Team-Sagittarius-ENTC/RGBsensor/poojitha/keyboard_second_solution/AKP-2.jpg

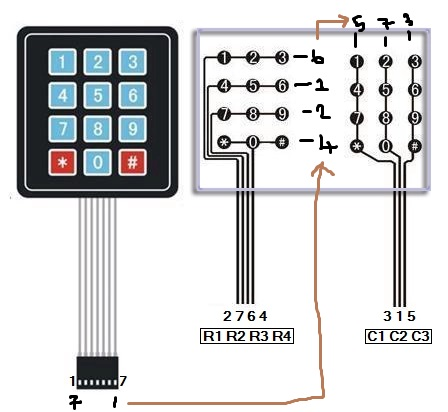
poojitha/keyboard_second_solution/AKP-2.jpg
