Team-Sagittarius-ENTC/RGBsensor/poojitha/keyboard_second_solution/AKP-2.webp

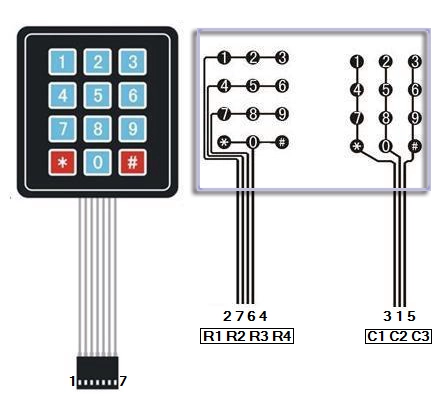
poojitha/keyboard_second_solution/AKP-2.webp
