Team-Sagittarius-ENTC/RGBsensor/Shared links.txt

Notion
------
https://www.notion.so/RGB-sensor-project-6d011d6d5c9f4d6bbc16852361c6ef57
