Team-Sagittarius-ENTC/RGBsensor/poojitha/Keypad and connections.pptx

## Keypad and connections

- To reduce the number of pins, we used resistor-based keypad(Now we use only one pin).
(idea : For pressing every key we get
different resultant resistor combination.)
- By practical, we obtain values for each key
pressed.

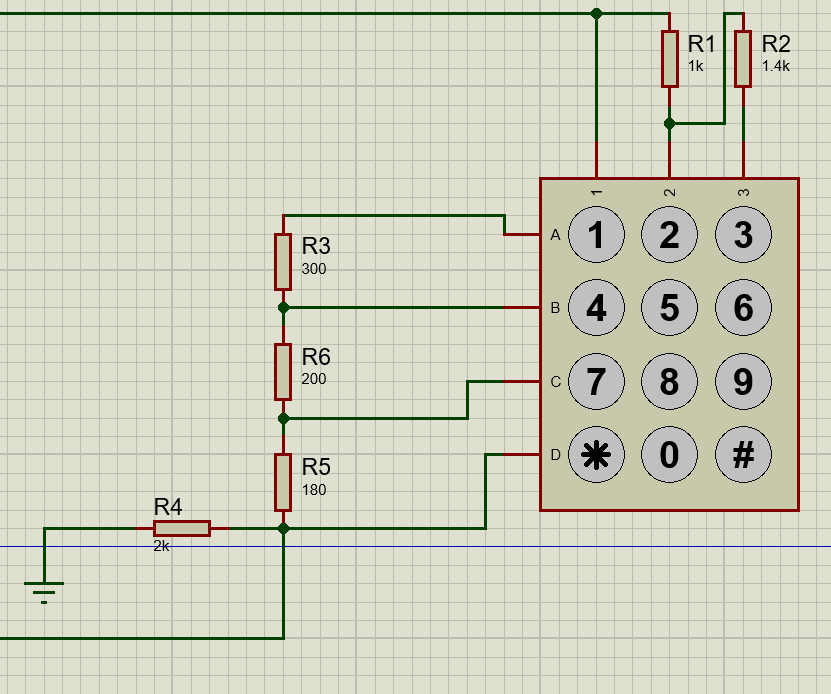
[picture p18: figure]

Get the analog read

## Keypad and connections

- Then we create Keypad library.

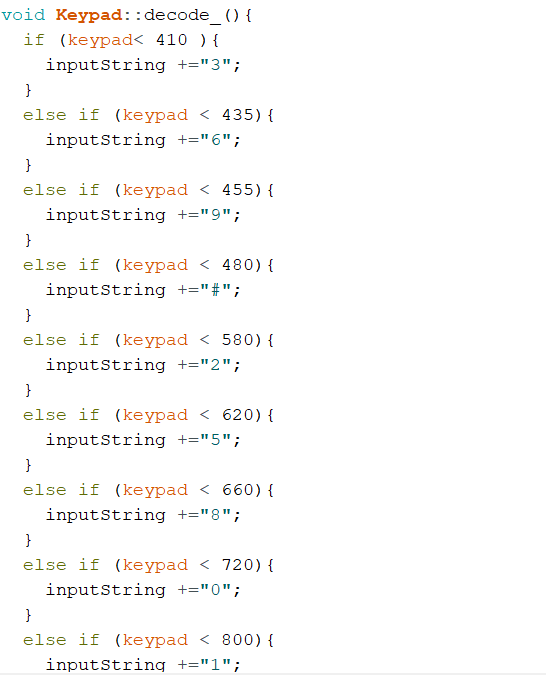
[picture p19: figure]
