Team-Sagittarius-ENTC/RGBsensor/kajhanan/Presentation 1.pptx

## Using I2C backpack module

- The usage of the i2c backpack module reduces the number of pins from 8 to 2.

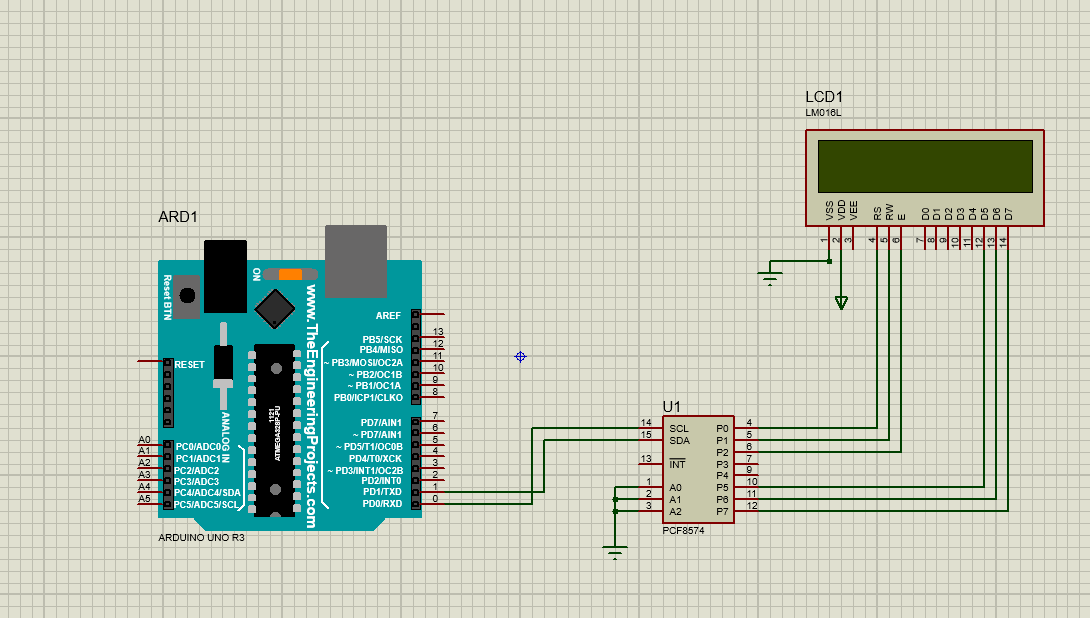
[picture p28: figure]
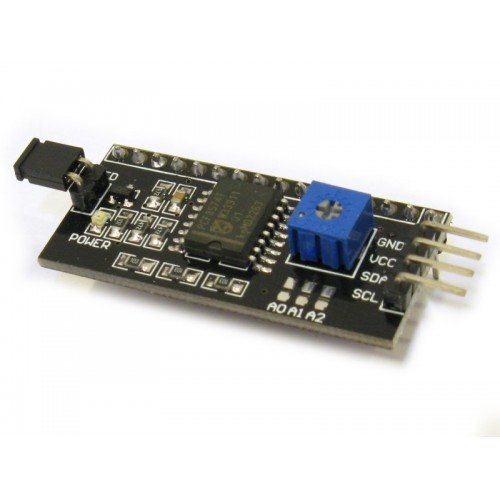
[picture p29: figure]
