Team-Sagittarius-ENTC/RGBsensor/yasiru/Power supply and TR wave generator.pdf

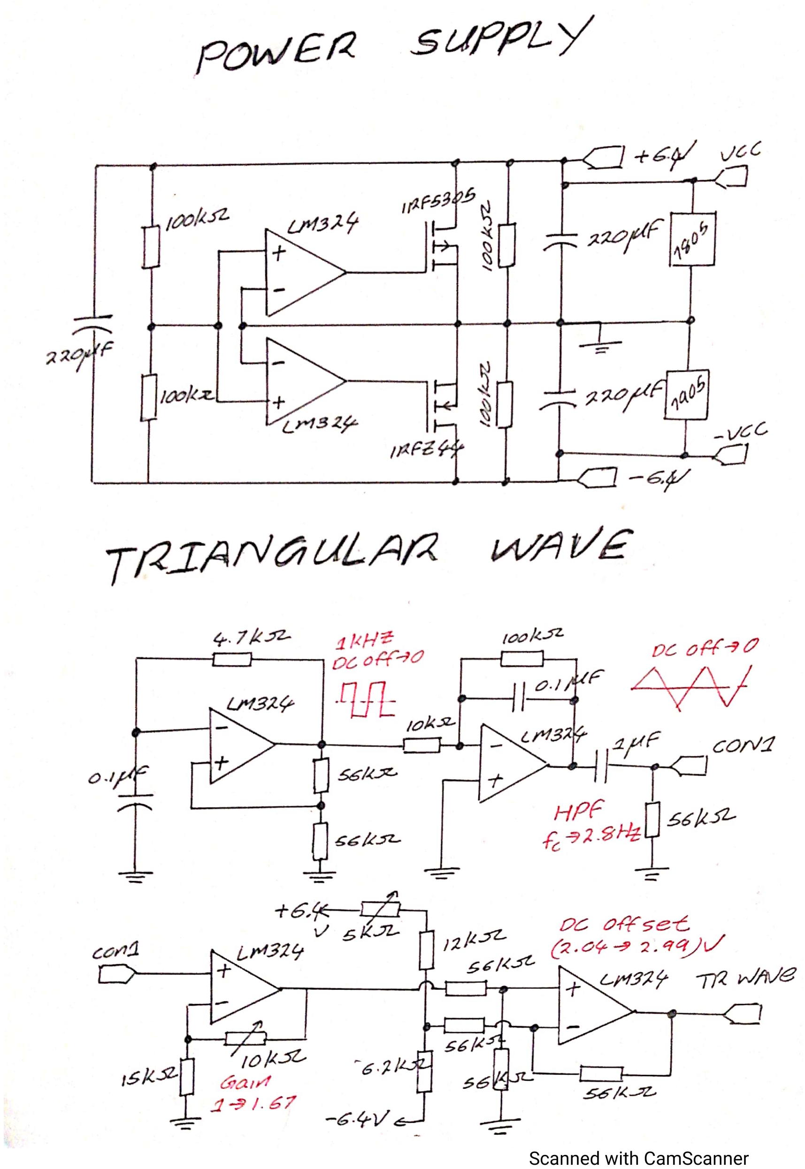
[picture p30: page 1]
