Team-Sagittarius-ENTC/RGBsensor/firmware/BT IFACE/BT IFACE/obj/connection.jpg

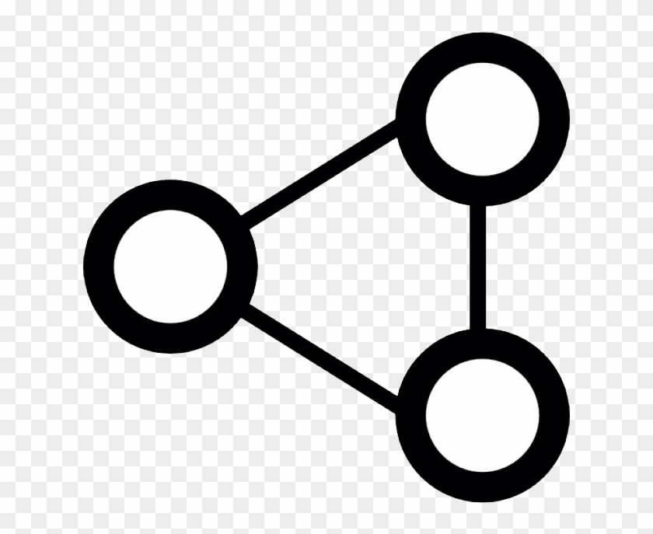
firmware/BT IFACE/BT IFACE/obj/connection.jpg
