Team-Sagittarius-ENTC/RGBsensor/firmware/BT IFACE/BT IFACE/obj/connection.png

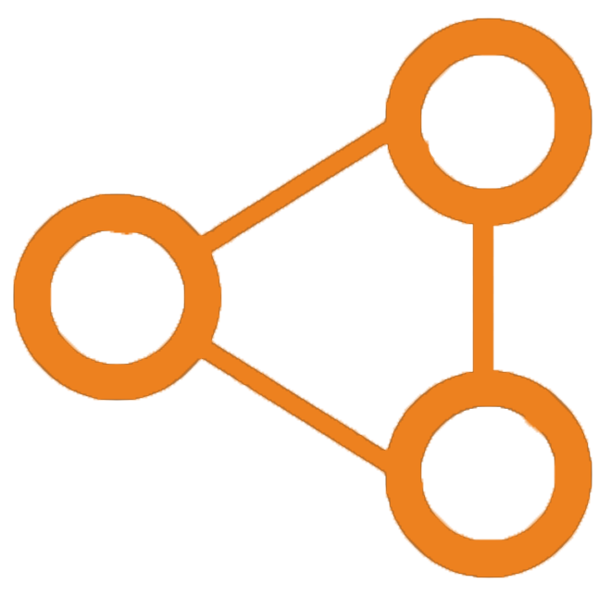
firmware/BT IFACE/BT IFACE/obj/connection.png
