Team-Sagittarius-ENTC/RGBsensor/firmware/BT IFACE/BT IFACE/obj/folder_file.png

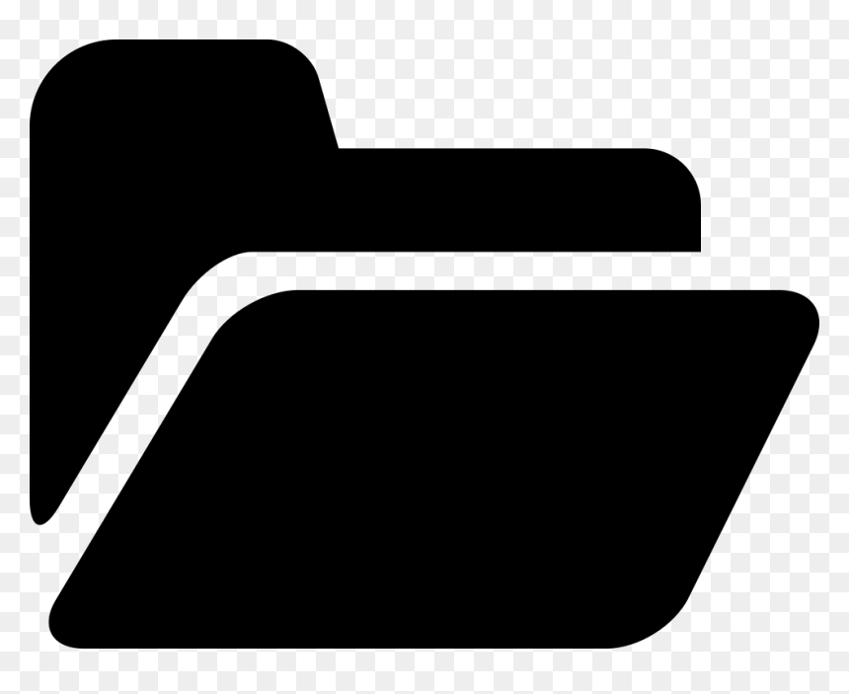
firmware/BT IFACE/BT IFACE/obj/folder_file.png
