Team-Sagittarius-ENTC/RGBsensor/firmware/BT IFACE/BT IFACE/obj/index.png

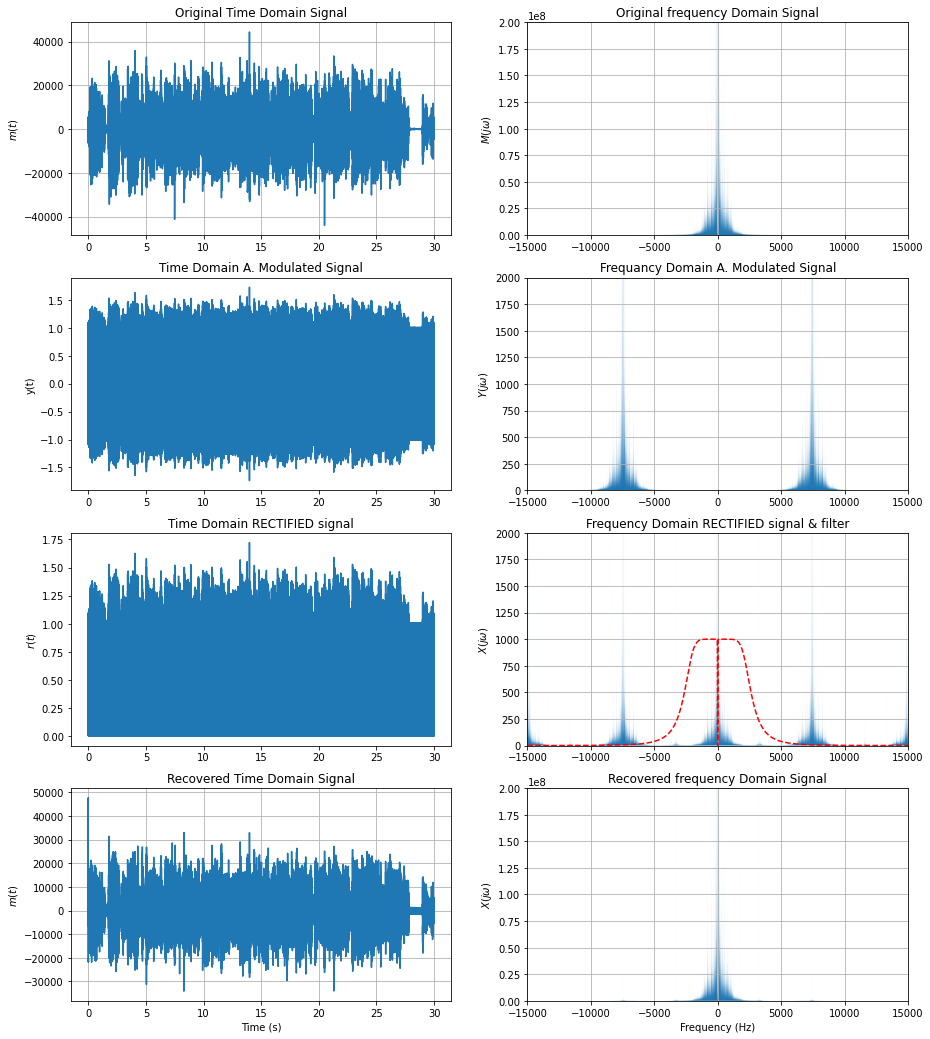
firmware/BT IFACE/BT IFACE/obj/index.png
