Team-Sagittarius-ENTC/RGBsensor/firmware/BT IFACE/BT IFACE/obj/large.PNG

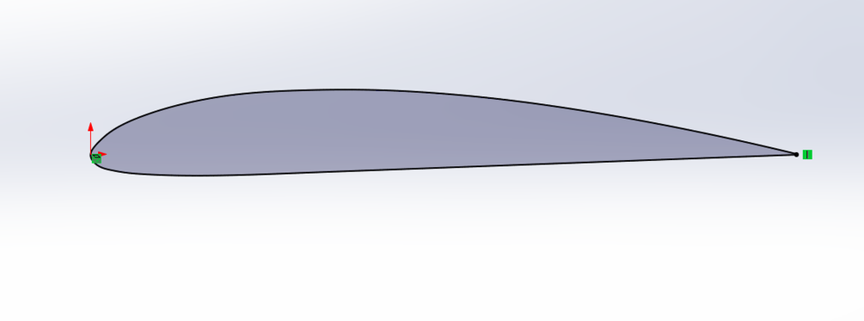
firmware/BT IFACE/BT IFACE/obj/large.PNG
