Team-Sagittarius-ENTC/RGBsensor/firmware/BT IFACE/BT IFACE/obj/options.jpg

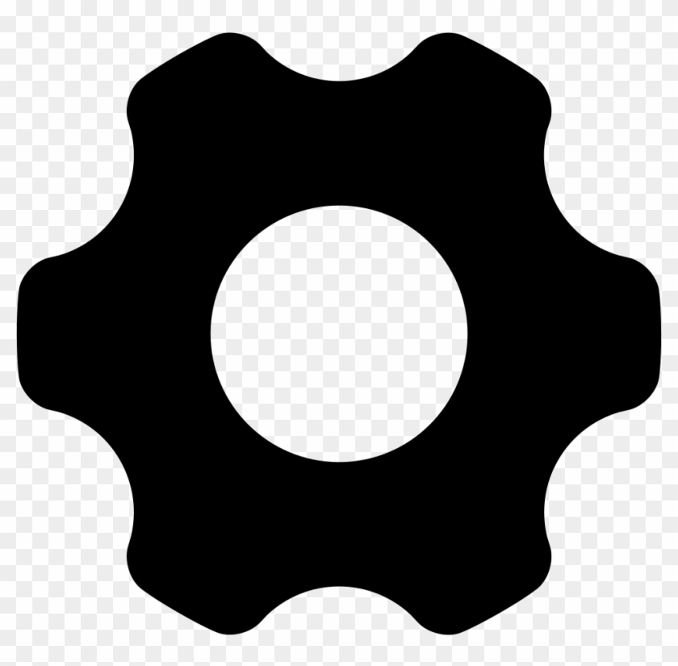
firmware/BT IFACE/BT IFACE/obj/options.jpg
