Team-Sagittarius-ENTC/RGBsensor/firmware/Optional/RawCaptures/Dark Green/ABG Ratio.png

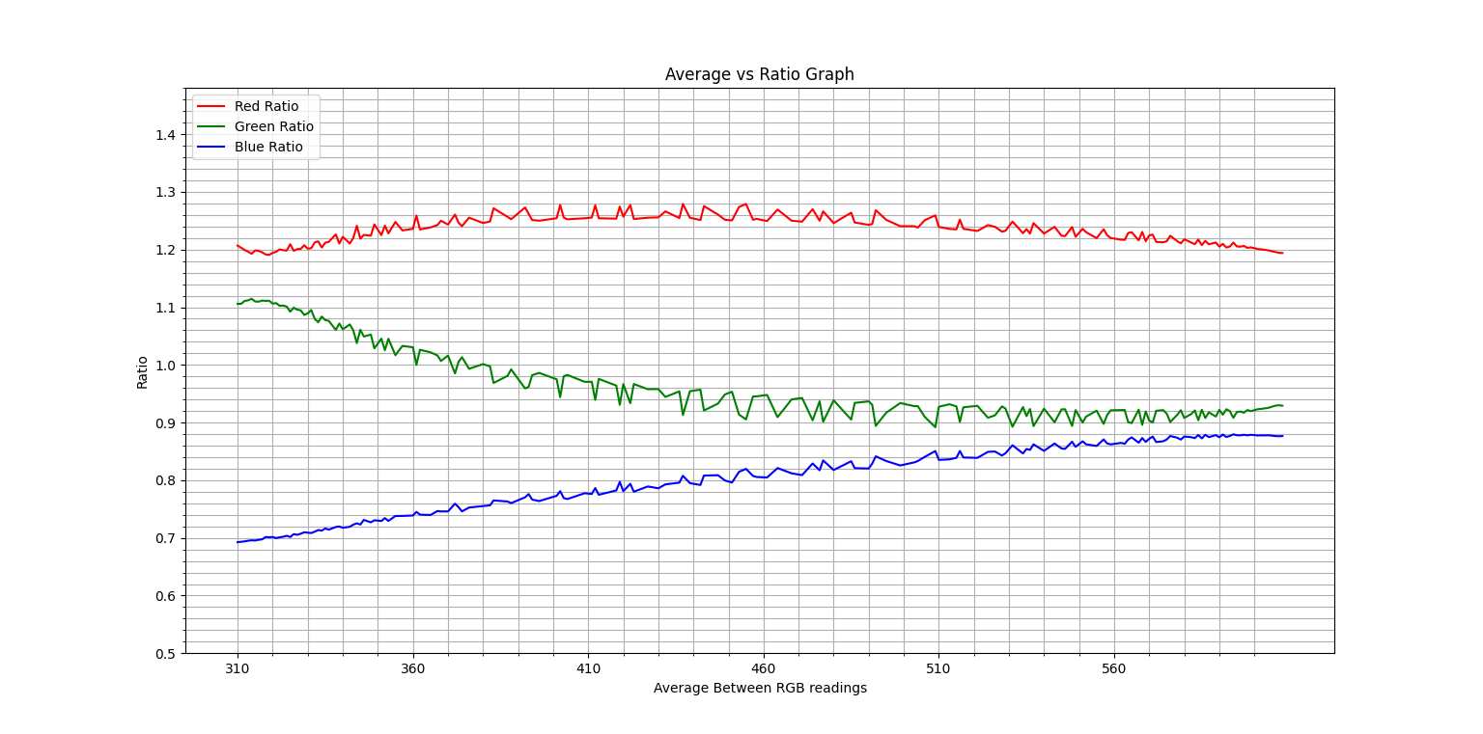
firmware/Optional/RawCaptures/Dark Green/ABG Ratio.png
