Team-Sagittarius-ENTC/RGBsensor/firmware/Optional/RawCaptures/Dark Green/Original.png

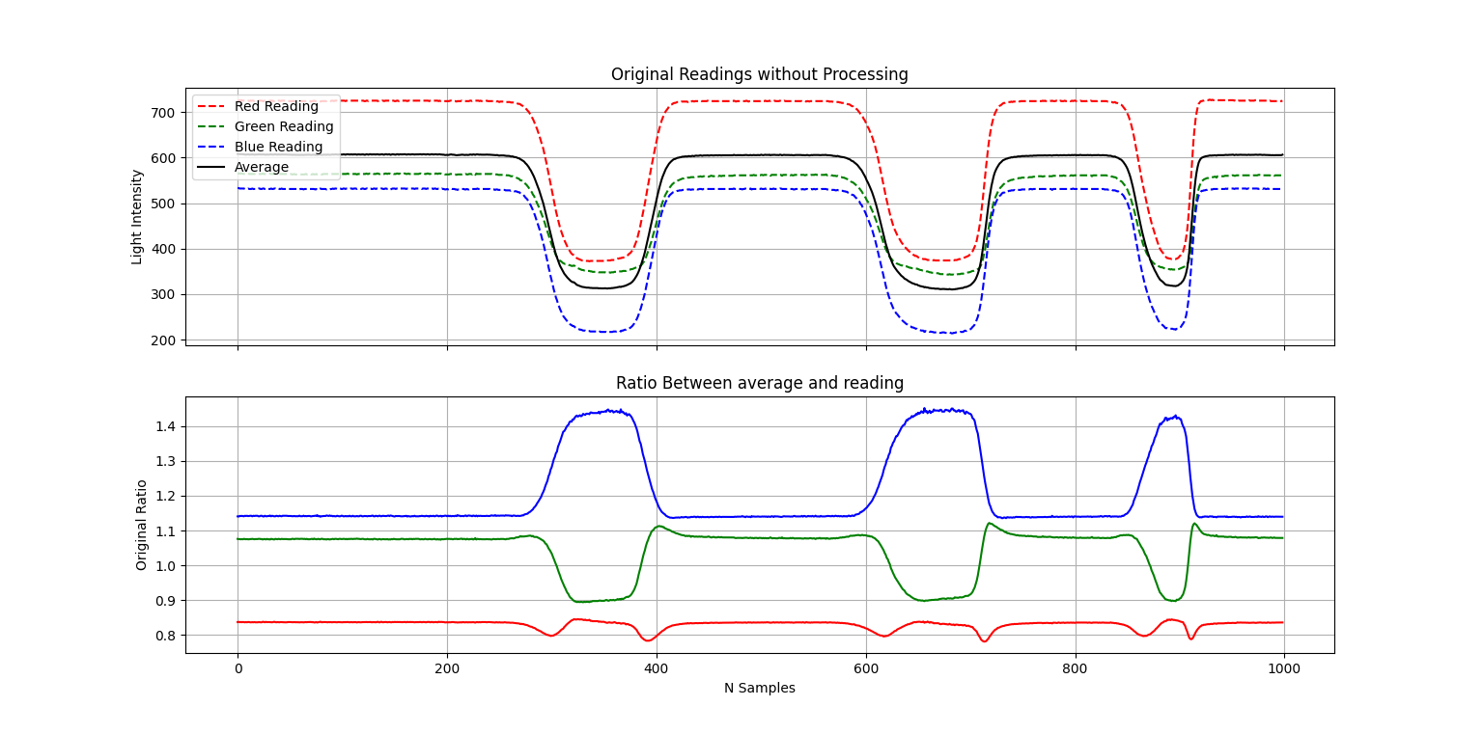
firmware/Optional/RawCaptures/Dark Green/Original.png
