Team-Sagittarius-ENTC/RGBsensor/firmware/Optional/RawCaptures/Dark Green/Processed.png

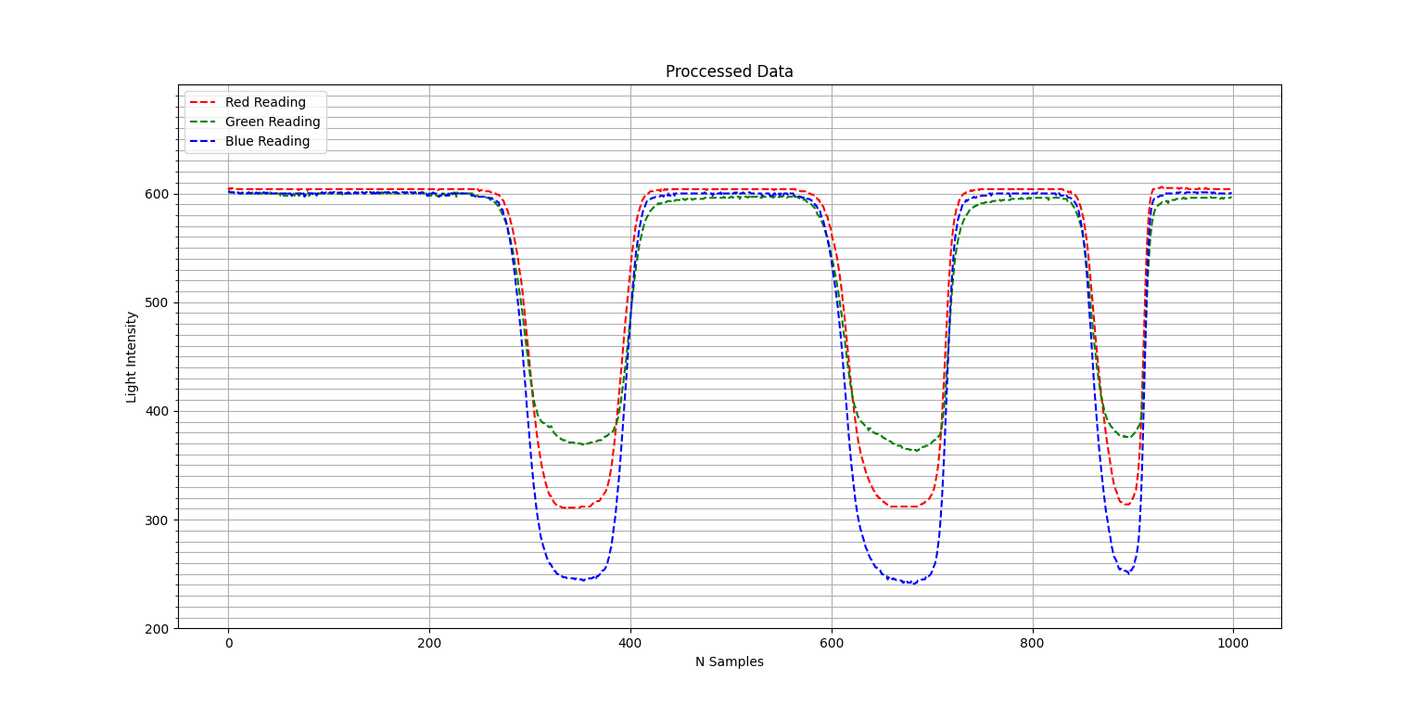
firmware/Optional/RawCaptures/Dark Green/Processed.png
