Team-Sagittarius-ENTC/RGBsensor/firmware/Optional/RawCaptures/Figure_1.png

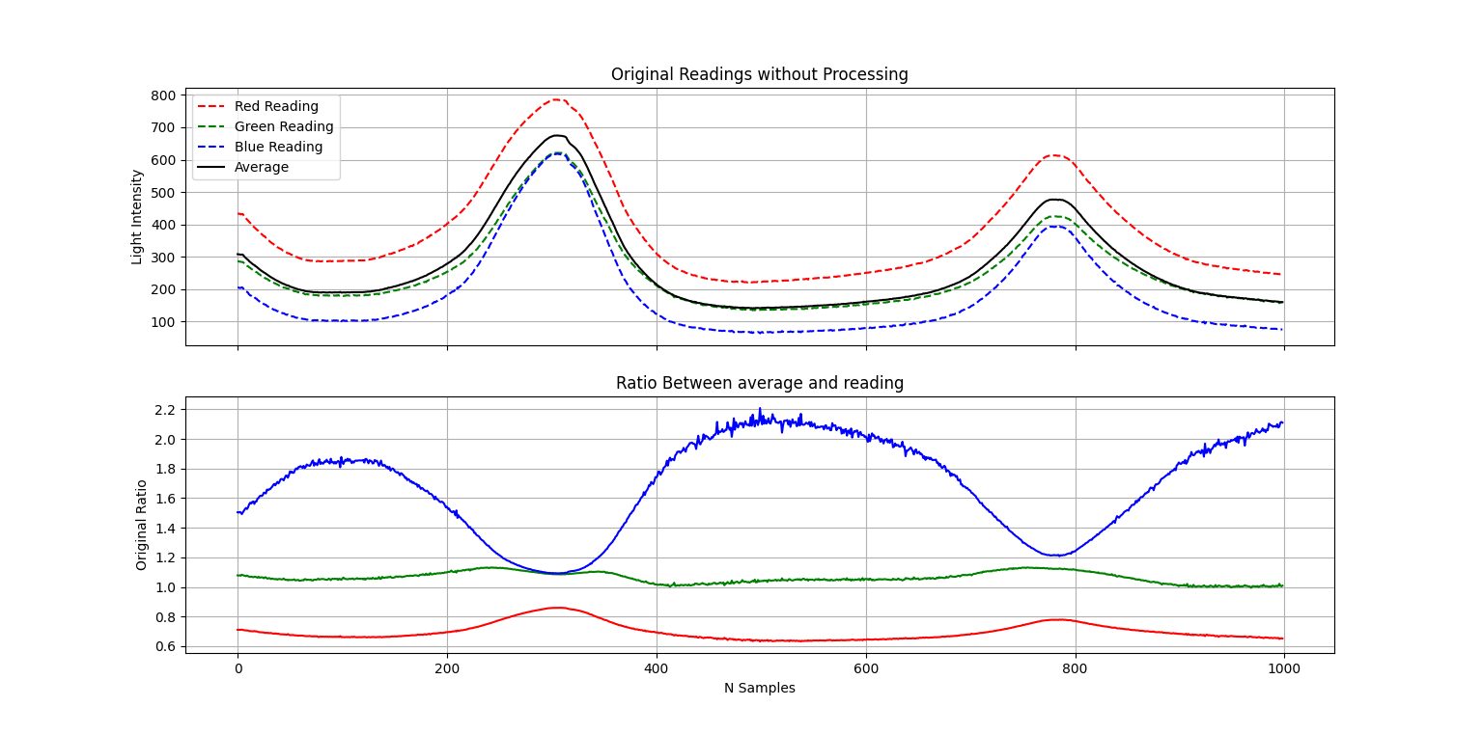
firmware/Optional/RawCaptures/Figure_1.png
