Team-Sagittarius-ENTC/RGBsensor/firmware/Optional/RawCaptures/Figure_2.png

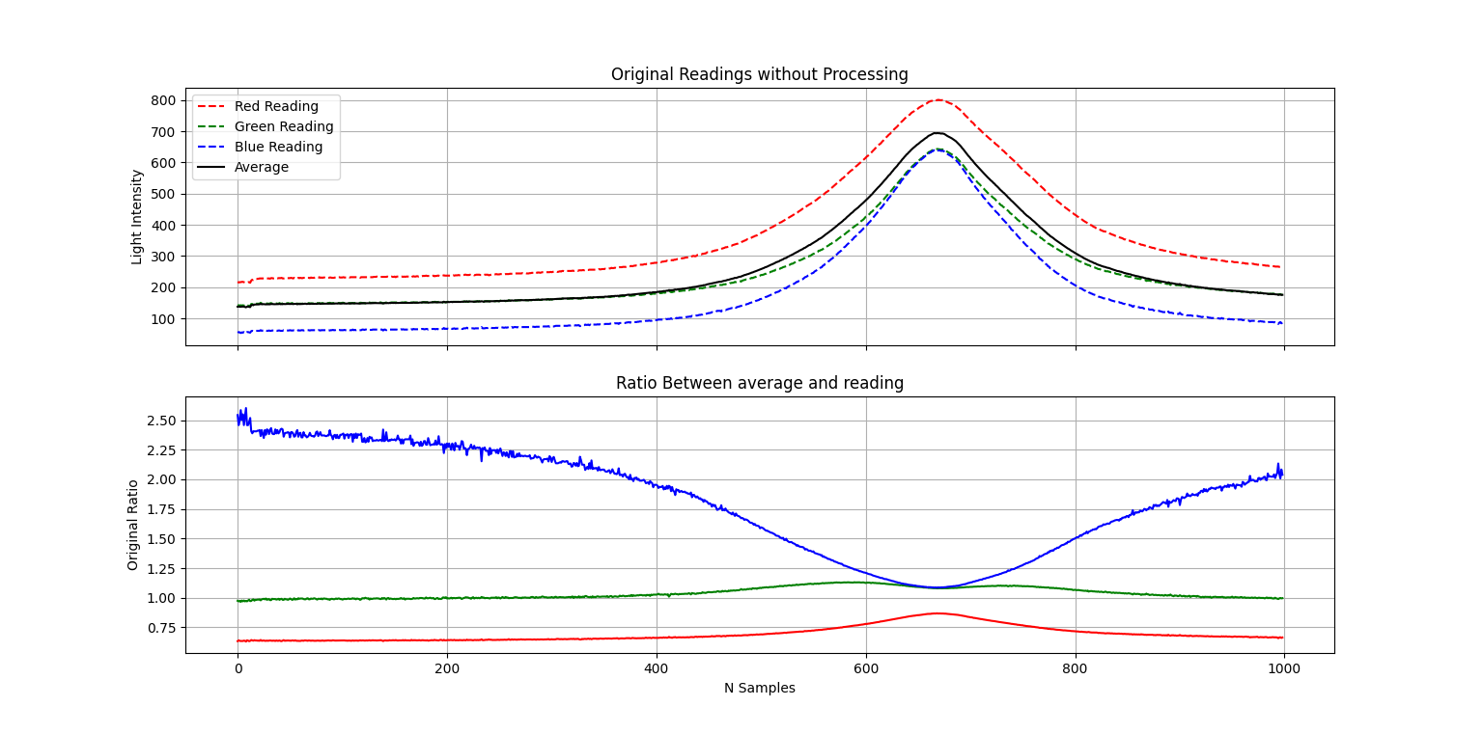
firmware/Optional/RawCaptures/Figure_2.png
