Team-Sagittarius-ENTC/RGBsensor/firmware/Optional/RawCaptures/Figure_3.png

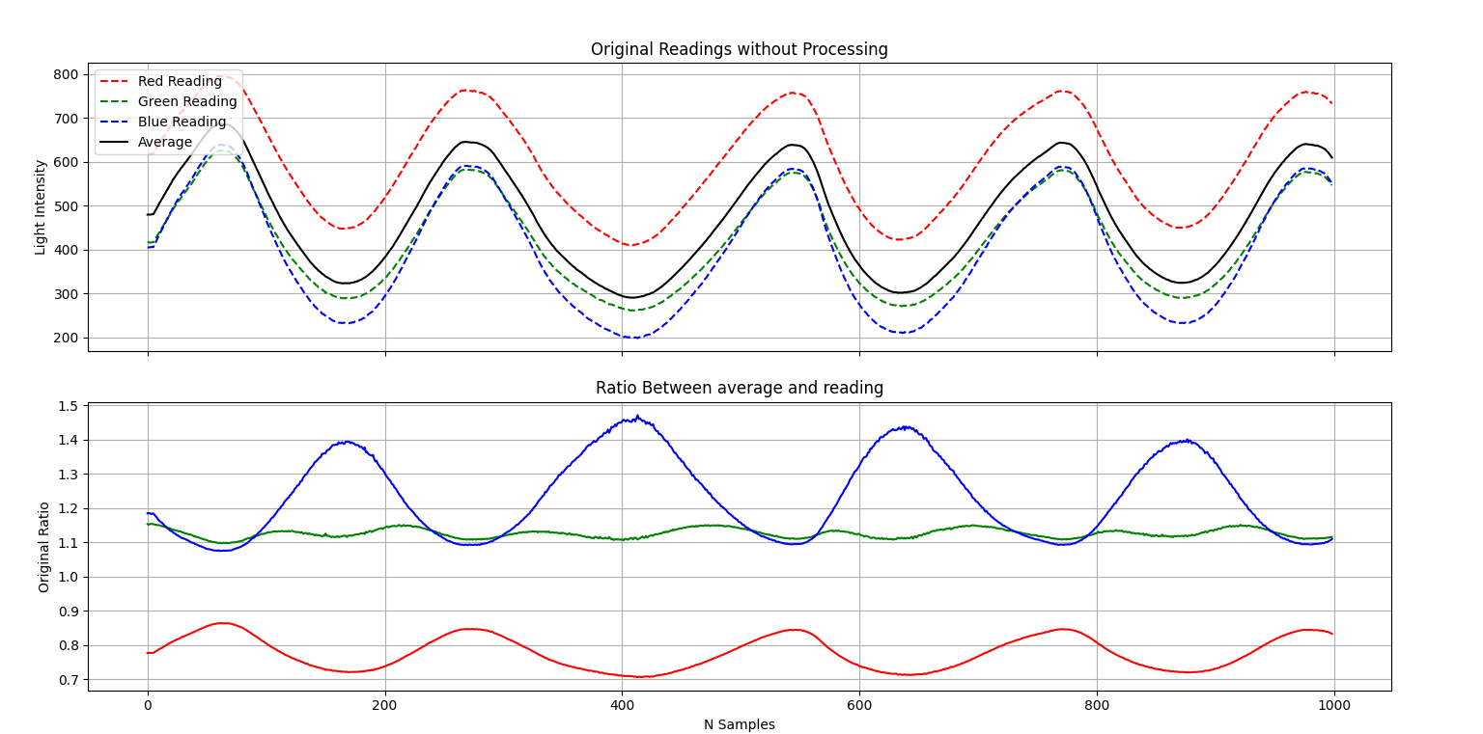
firmware/Optional/RawCaptures/Figure_3.png
