Team-Sagittarius-ENTC/RGBsensor/firmware/Optional/RawCaptures/Figure_3_Average_vs_Ratio.png

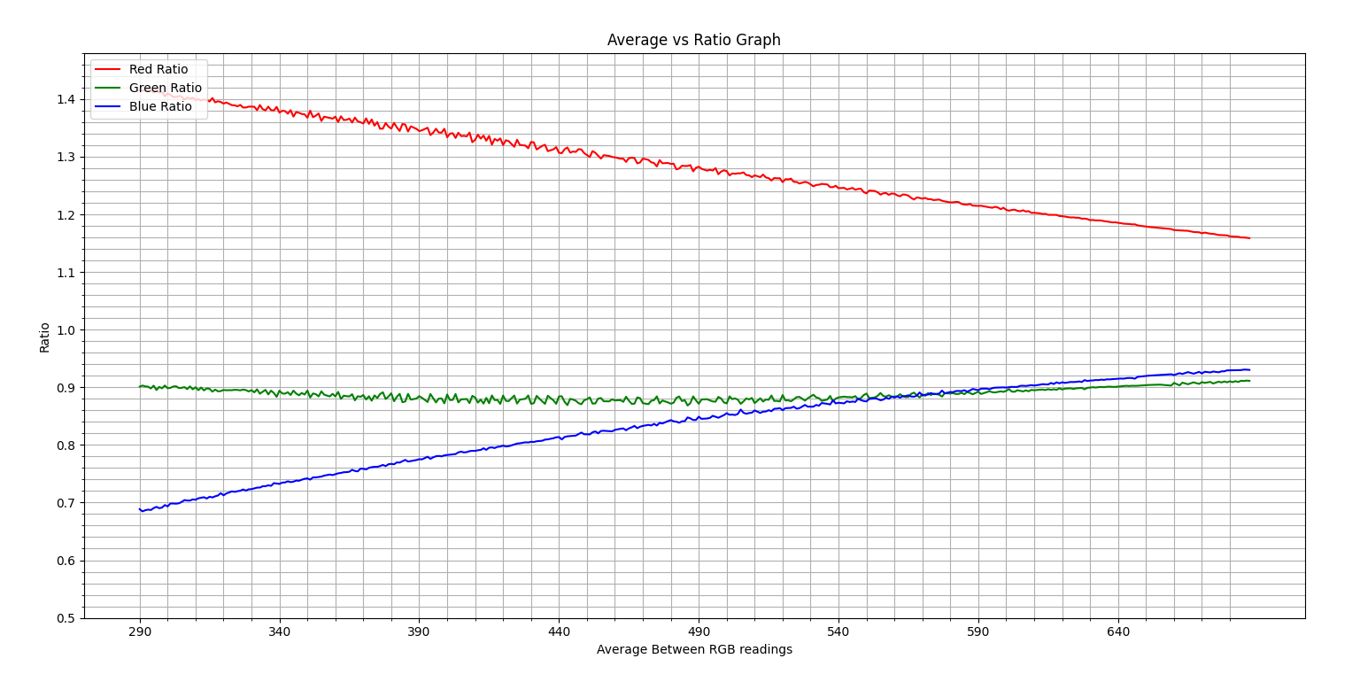
firmware/Optional/RawCaptures/Figure_3_Average_vs_Ratio.png
