Team-Sagittarius-ENTC/RGBsensor/firmware/Optional/RawCaptures/Light Green/AVG Ratio.png

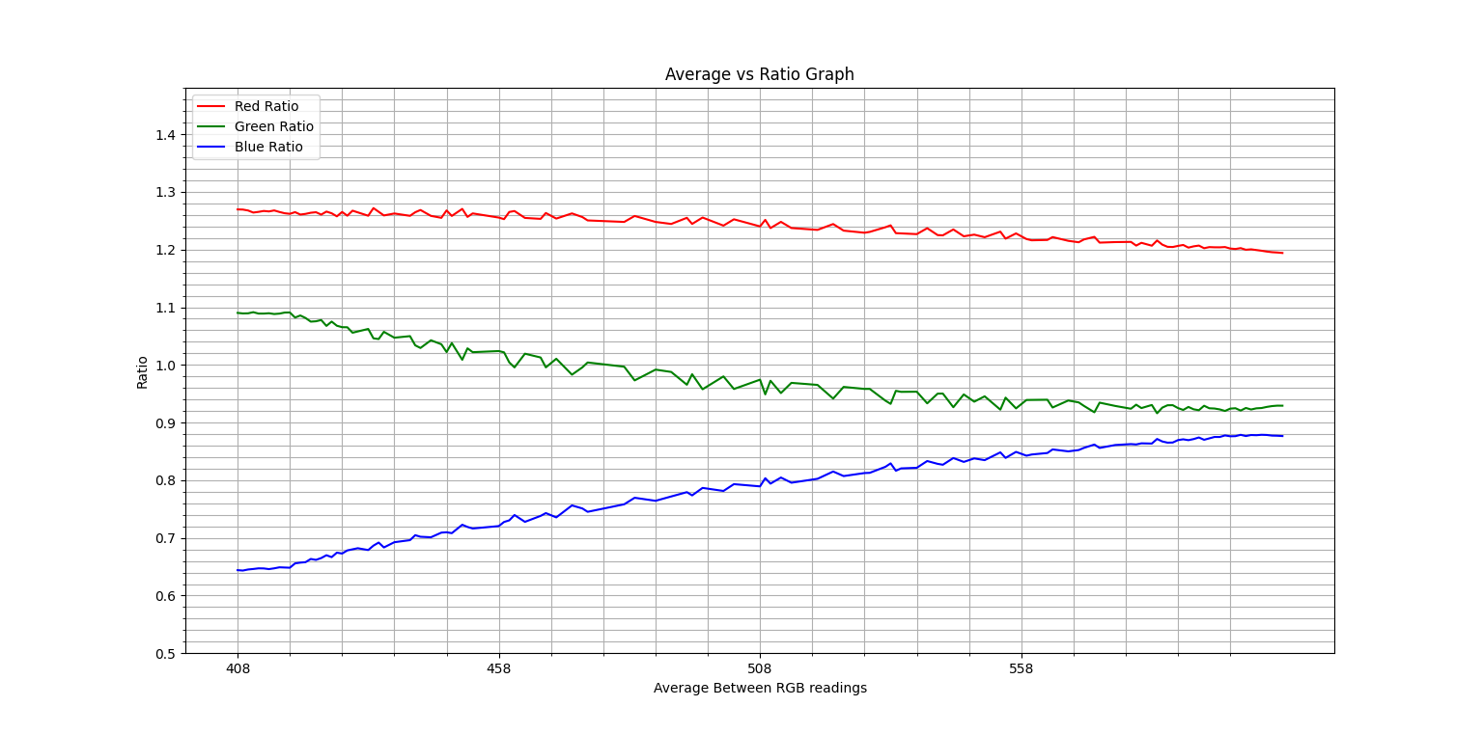
firmware/Optional/RawCaptures/Light Green/AVG Ratio.png
