Team-Sagittarius-ENTC/RGBsensor/firmware/Optional/RawCaptures/Light Green/Original.png

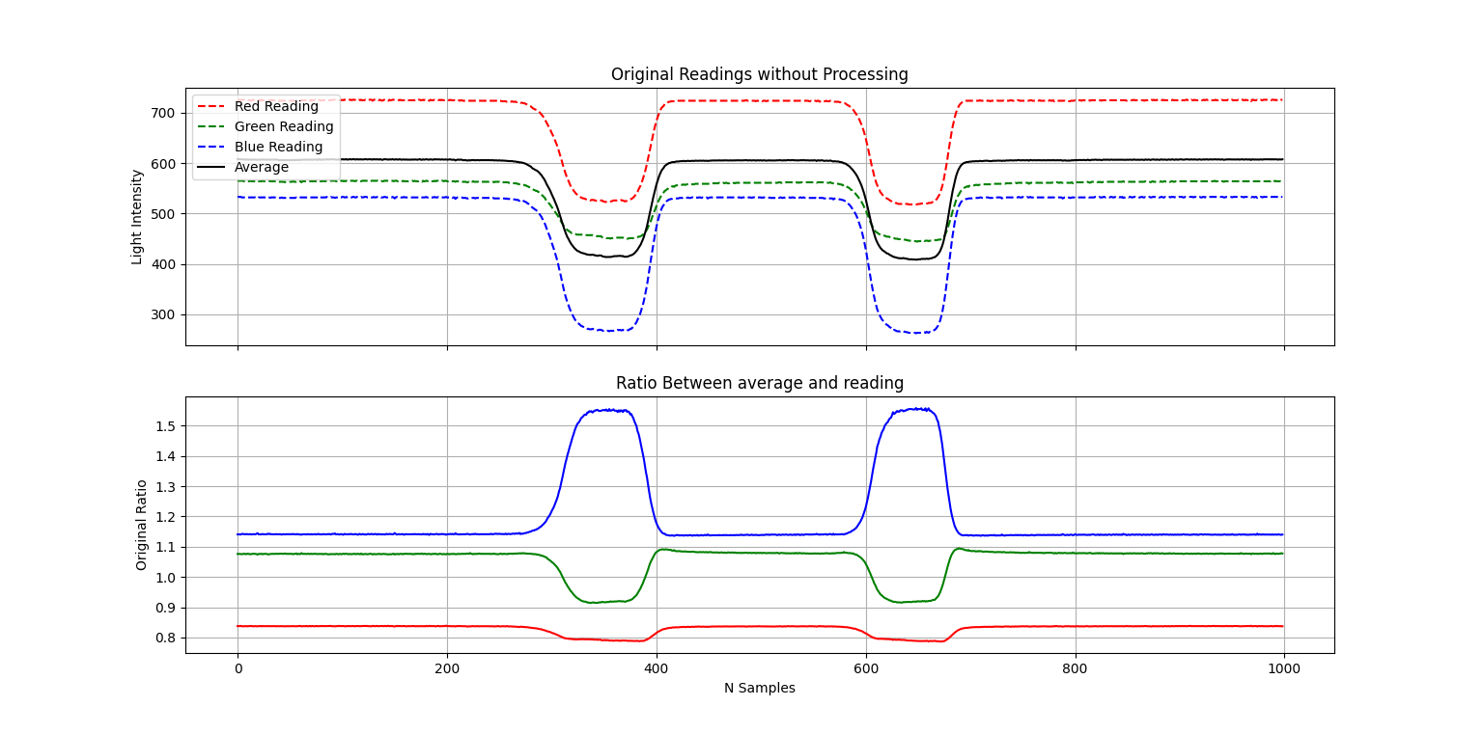
firmware/Optional/RawCaptures/Light Green/Original.png
