Team-Sagittarius-ENTC/RGBsensor/firmware/Optional/RawCaptures/Light Green/Processed.png

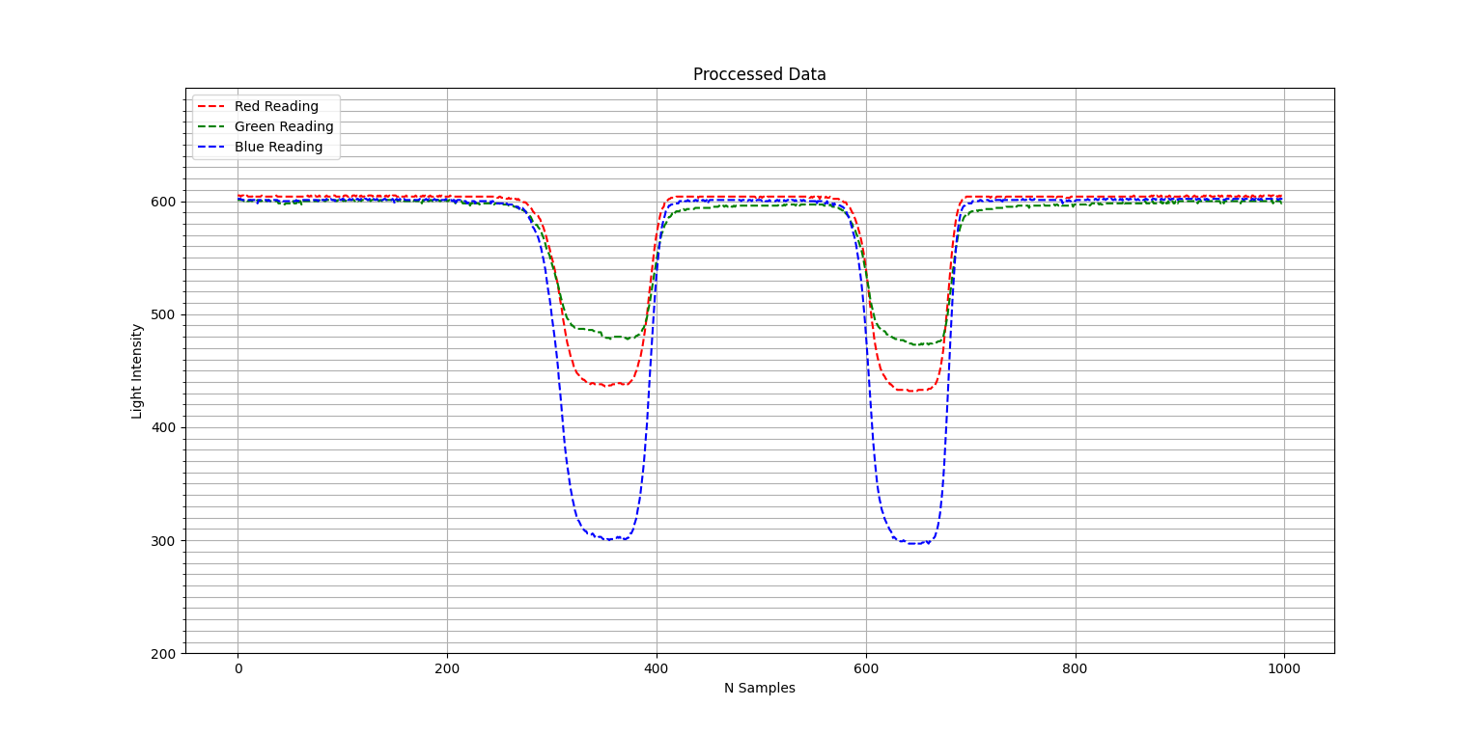
firmware/Optional/RawCaptures/Light Green/Processed.png
