Team-Sagittarius-ENTC/RGBsensor/firmware/Optional/RawCaptures/RedCap/Average vs Ratio.png

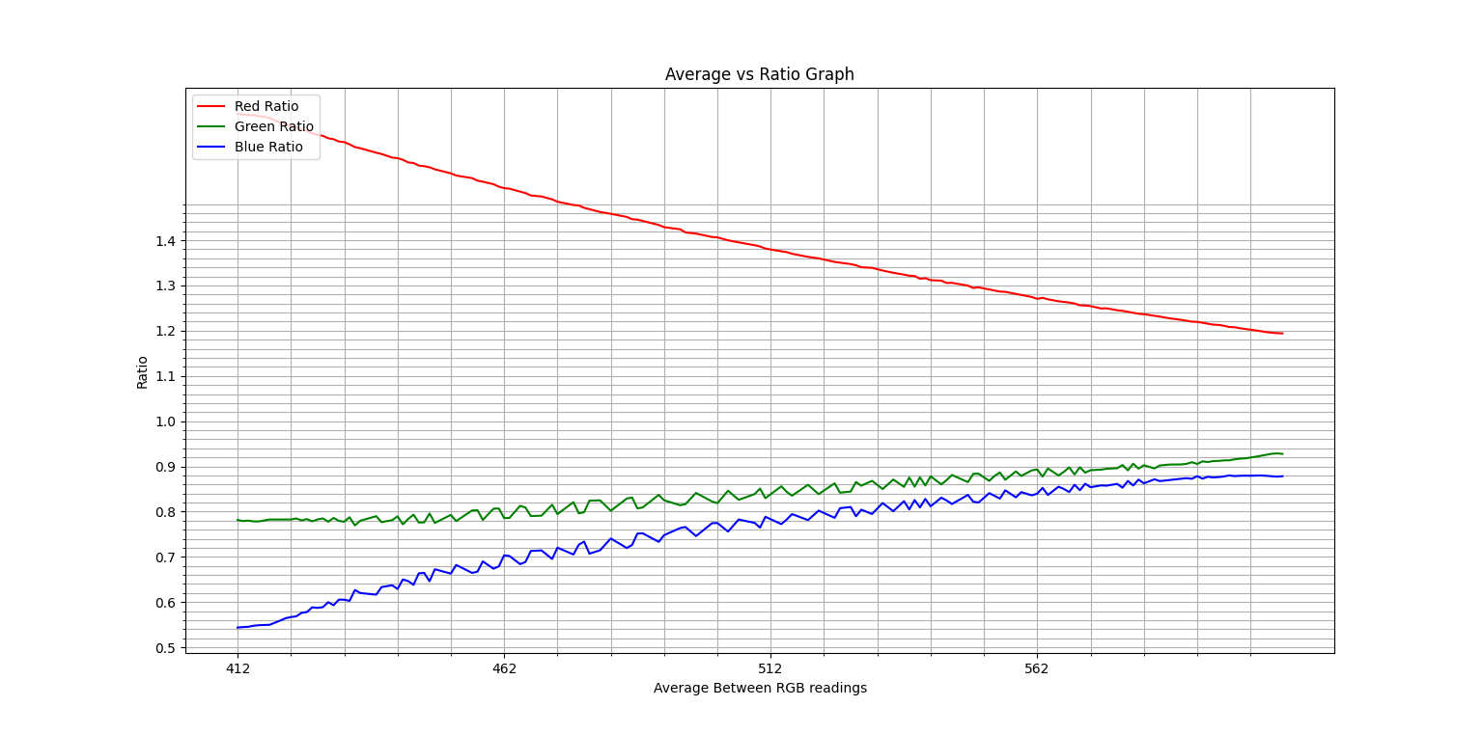
firmware/Optional/RawCaptures/RedCap/Average vs Ratio.png
