Team-Sagittarius-ENTC/RGBsensor/firmware/Optional/RawCaptures/RedCap/Original.png

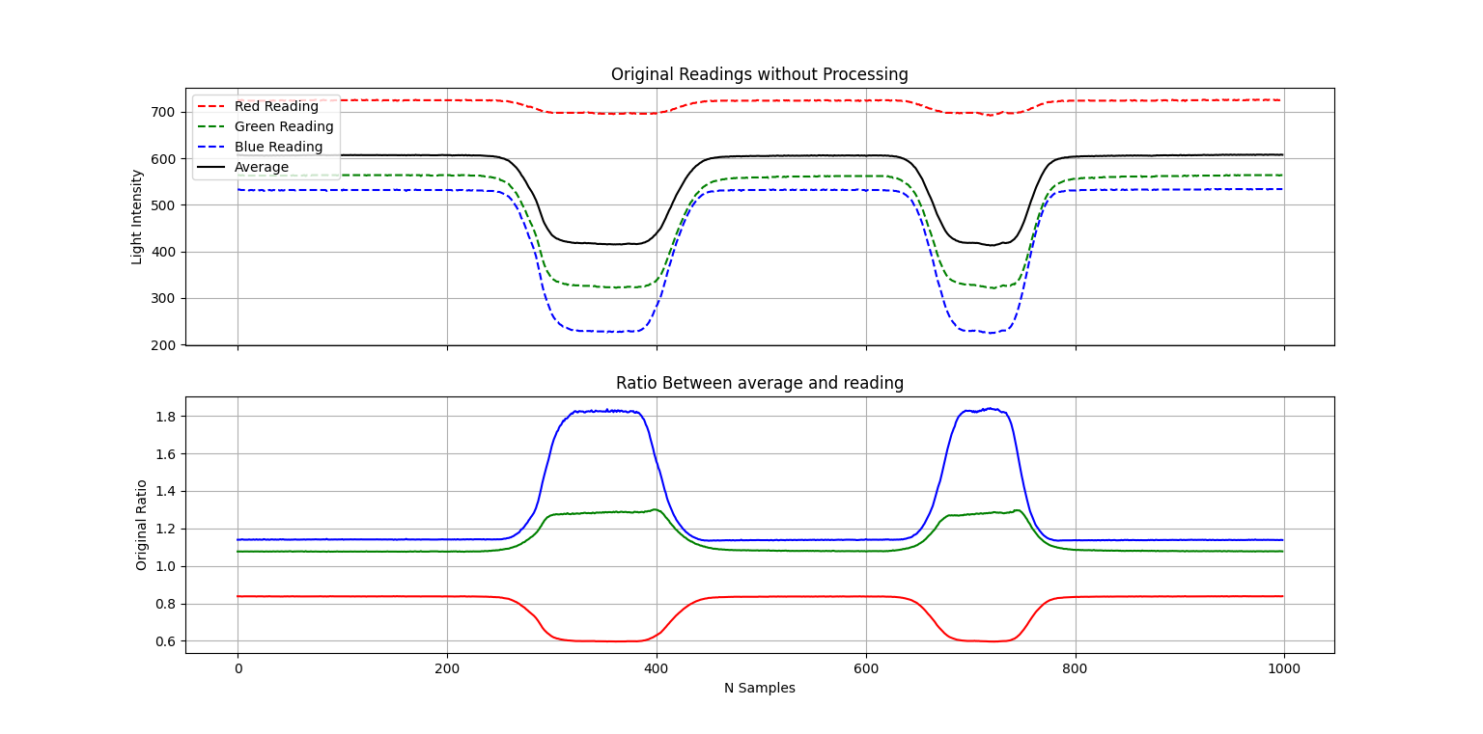
firmware/Optional/RawCaptures/RedCap/Original.png
