Team-Sagittarius-ENTC/RGBsensor/firmware/Optional/RawCaptures/RedCap/Proccessed.png

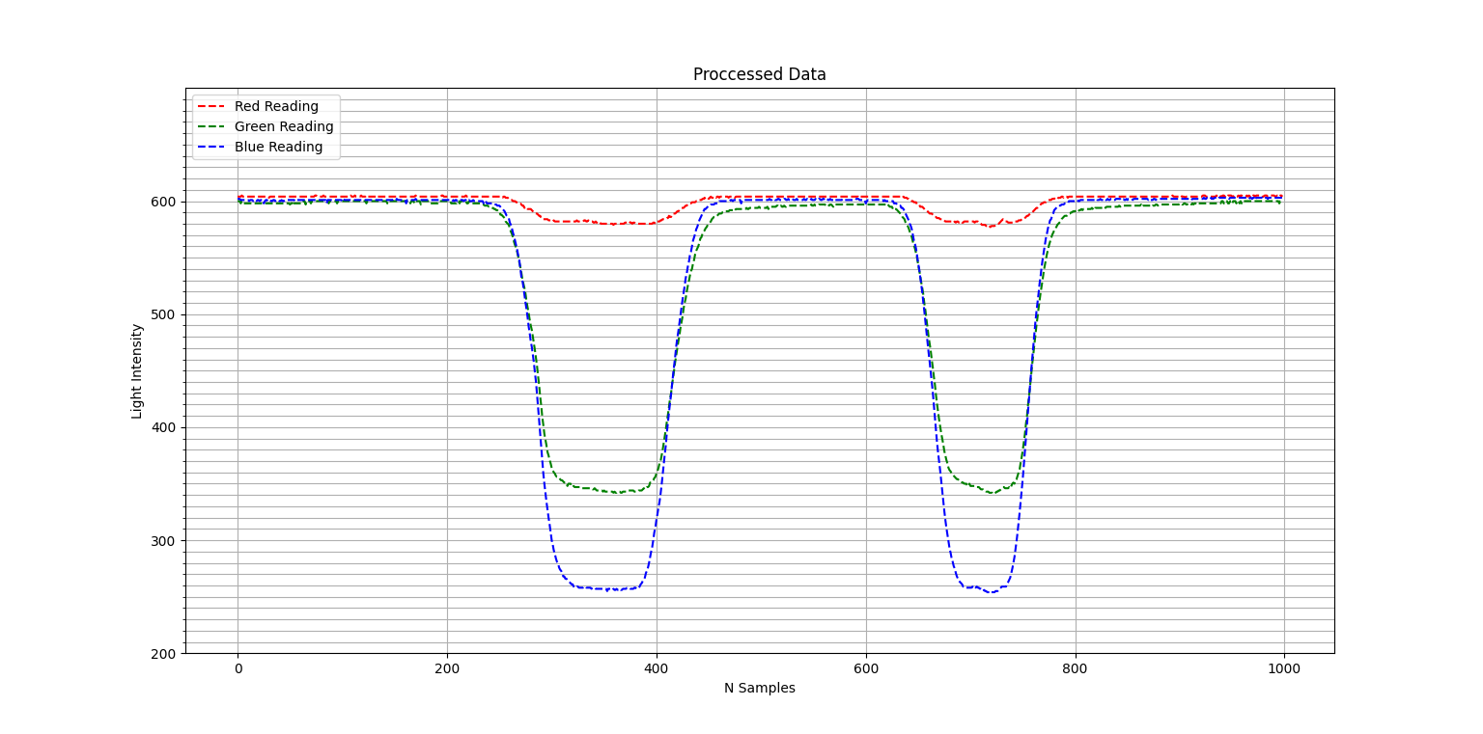
firmware/Optional/RawCaptures/RedCap/Proccessed.png
