Team-Sagittarius-ENTC/RGBsensor/poojitha/keyboard_second_solution/arduino pins .jpg

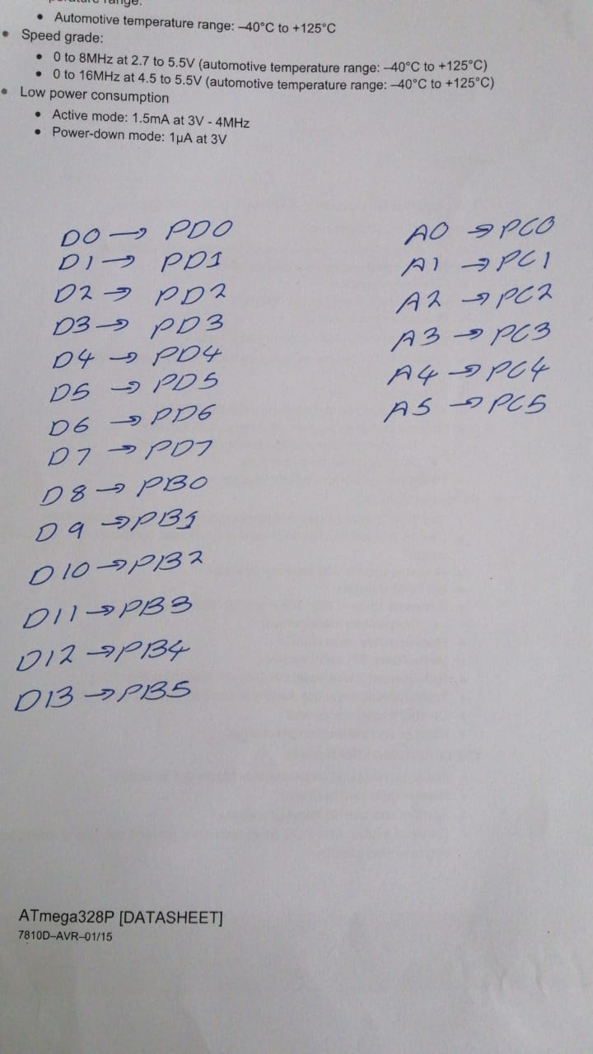
poojitha/keyboard_second_solution/arduino pins .jpg
