Team-Sagittarius-ENTC/RGBsensor/prabhashwara/flowchart.jpg

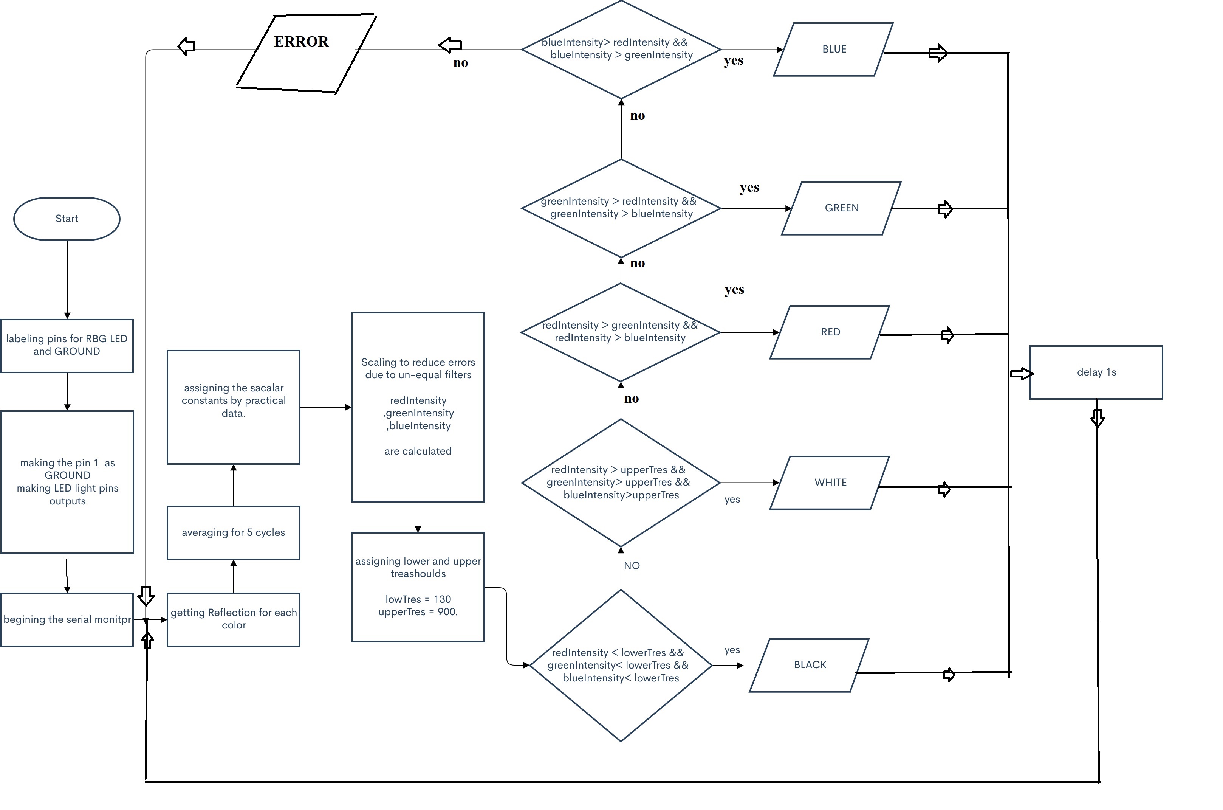
prabhashwara/flowchart.jpg
