Team-Sagittarius-ENTC/RGBsensor/prabhashwara/from yasiru ss/initializing page 23.png

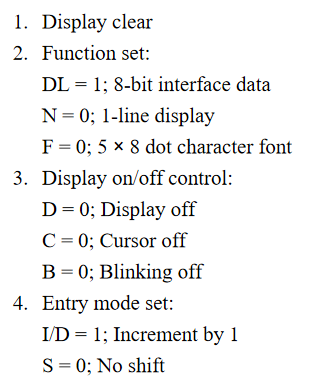
prabhashwara/from yasiru ss/initializing page 23.png
