Team-Sagittarius-ENTC/RGBsensor/prabhashwara/from yasiru ss/page 9.png

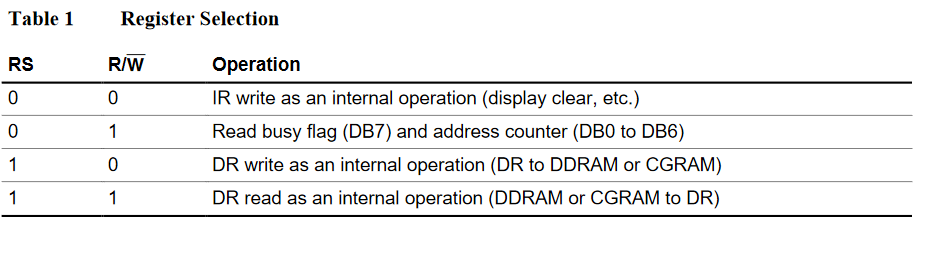
prabhashwara/from yasiru ss/page 9.png
