Team-Sagittarius-ENTC/RGBsensor/prabhashwara/from yasiru ss/page 11.png

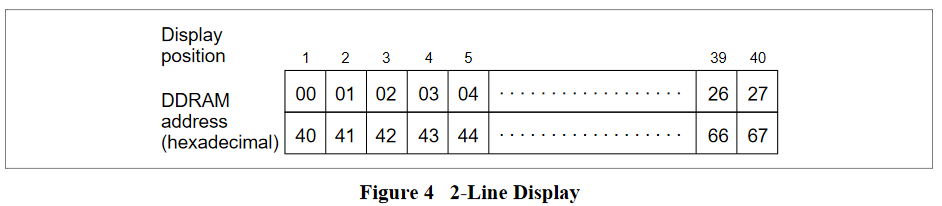
prabhashwara/from yasiru ss/page 11.png
