Team-Sagittarius-ENTC/RGBsensor/yasiru/4x4-Matrix-Keypad-OneWire_bb-1024x828.png

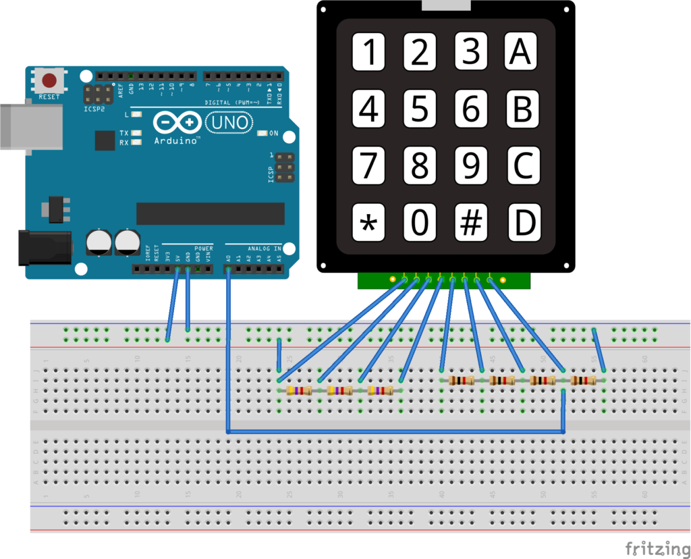
yasiru/4x4-Matrix-Keypad-OneWire_bb-1024x828.png
