Team-Sagittarius-ENTC/RGBsensor/yasiru/27_st7920_fig_01_96.png

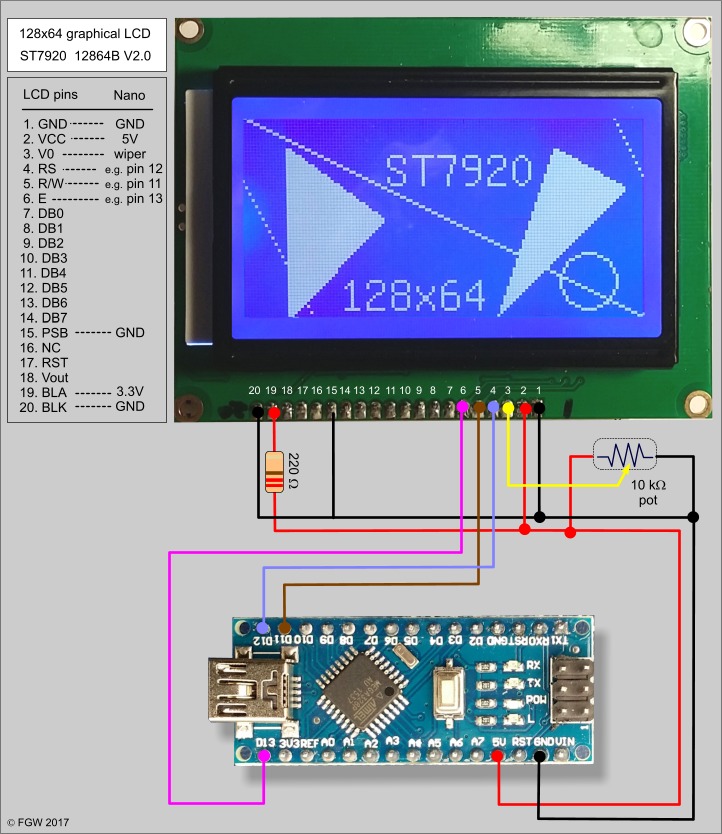
yasiru/27_st7920_fig_01_96.png
