Team-Sagittarius-ENTC/RGBsensor/yasiru/atmega328p-pinout.jpg

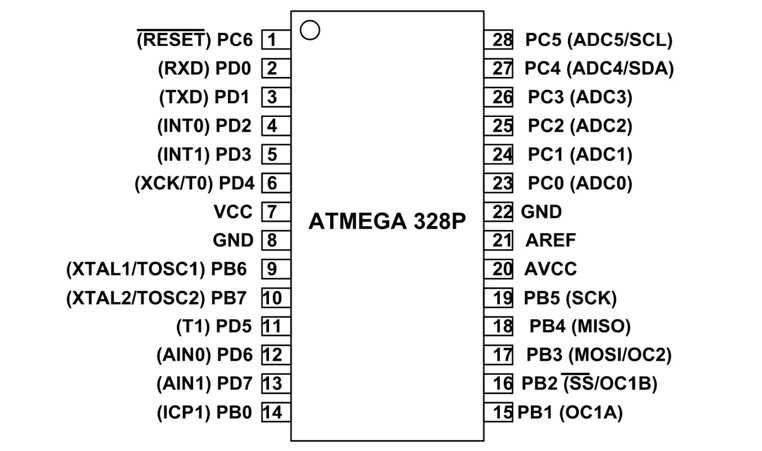
yasiru/atmega328p-pinout.jpg
