Team-Sagittarius-ENTC/RGBsensor/yasiru/ef5d8f31e240f69f03142a351cd0ef89.png

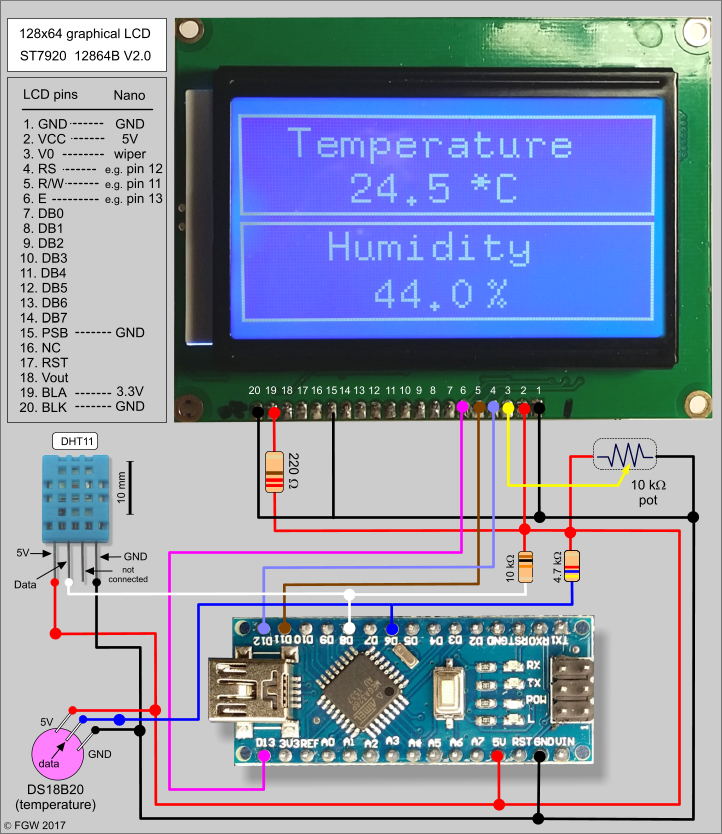
yasiru/ef5d8f31e240f69f03142a351cd0ef89.png
