Team-Sagittarius-ENTC/RGBsensor/yasiru/flowcharts/Sensing/RGB Main Flow chart - Page 1.jpeg

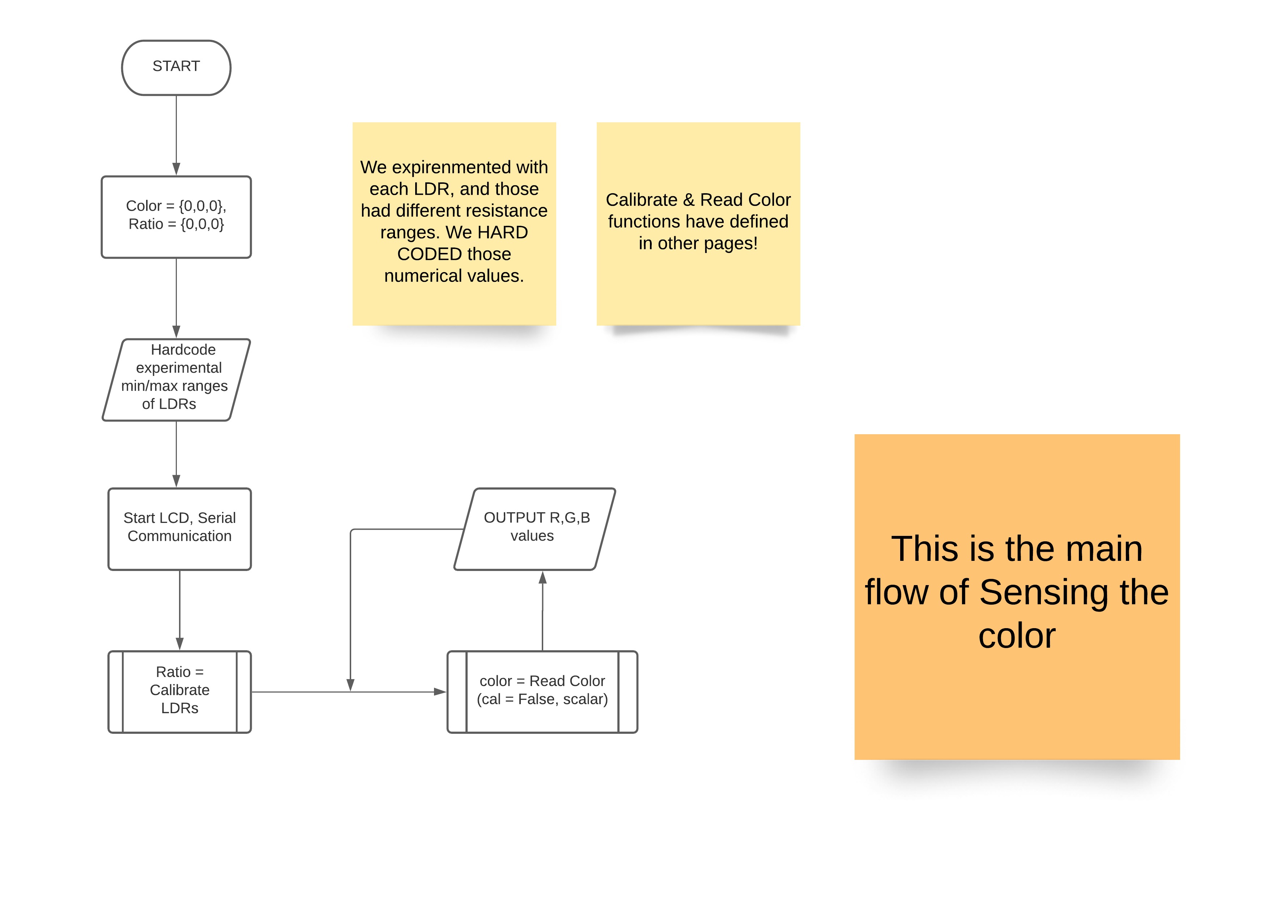
yasiru/flowcharts/Sensing/RGB Main Flow chart - Page 1.jpeg
