Team-Sagittarius-ENTC/RGBsensor/yasiru/flowcharts/Sensing/RGB Main Flow chart - Page 2.jpeg

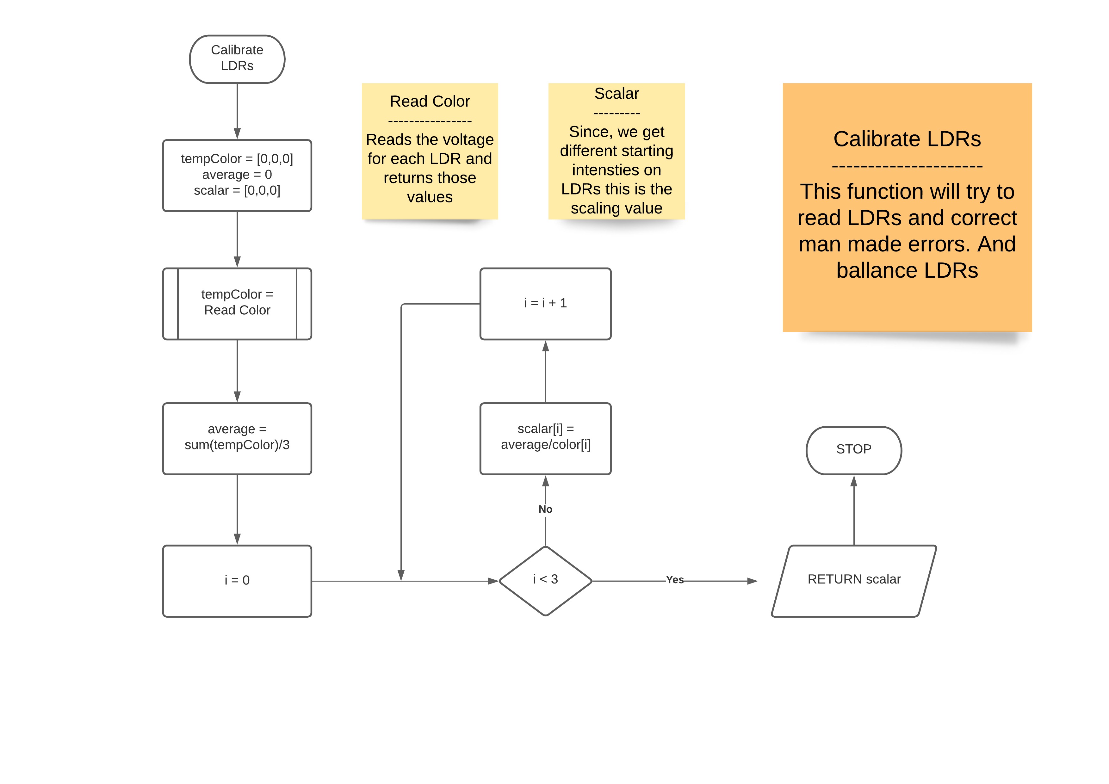
yasiru/flowcharts/Sensing/RGB Main Flow chart - Page 2.jpeg
