Team-Sagittarius-ENTC/RGBsensor/yasiru/flowcharts/Sensing/RGB Main Flow chart - Page 3.jpeg

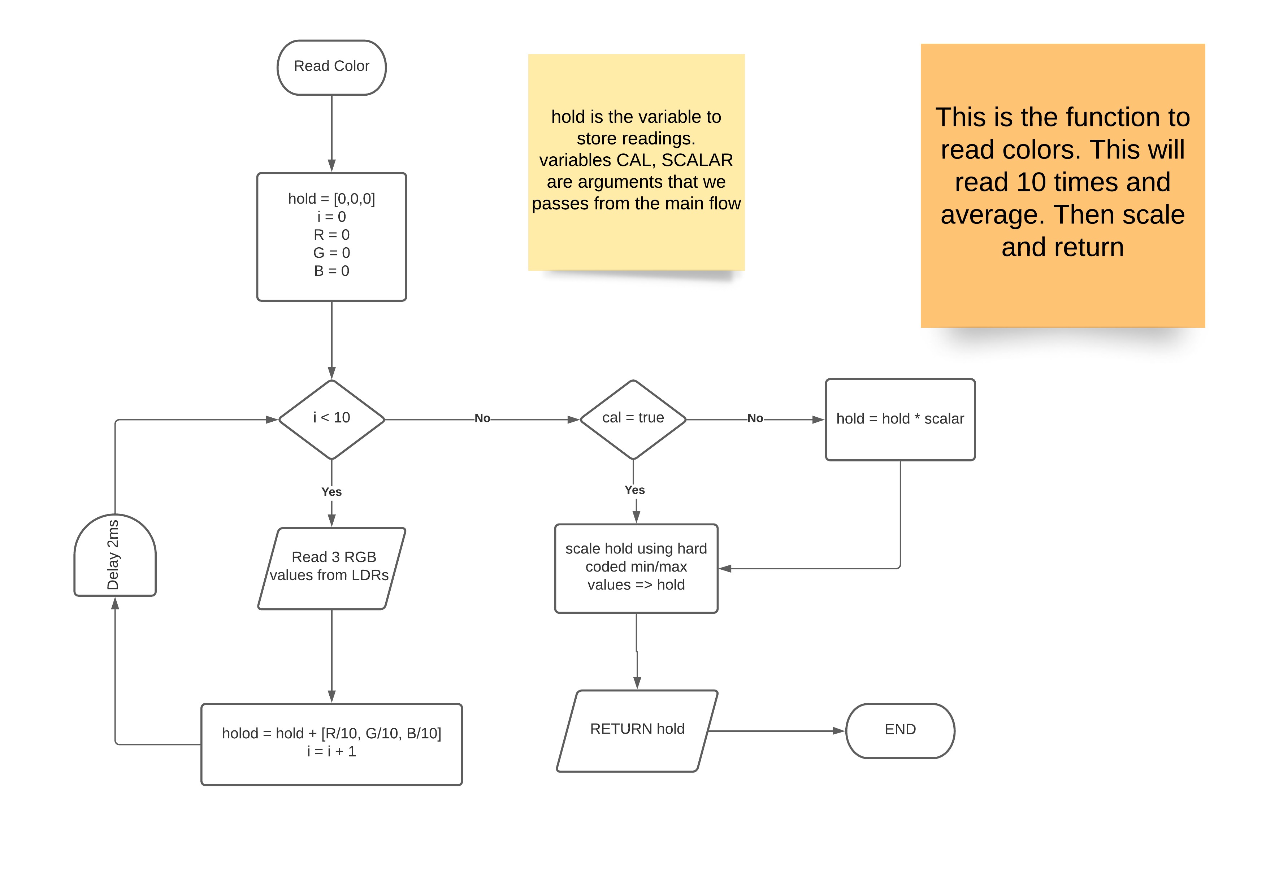
yasiru/flowcharts/Sensing/RGB Main Flow chart - Page 3.jpeg
