Team-Sagittarius-ENTC/RGBsensor/yasiru/keypad_bb.png

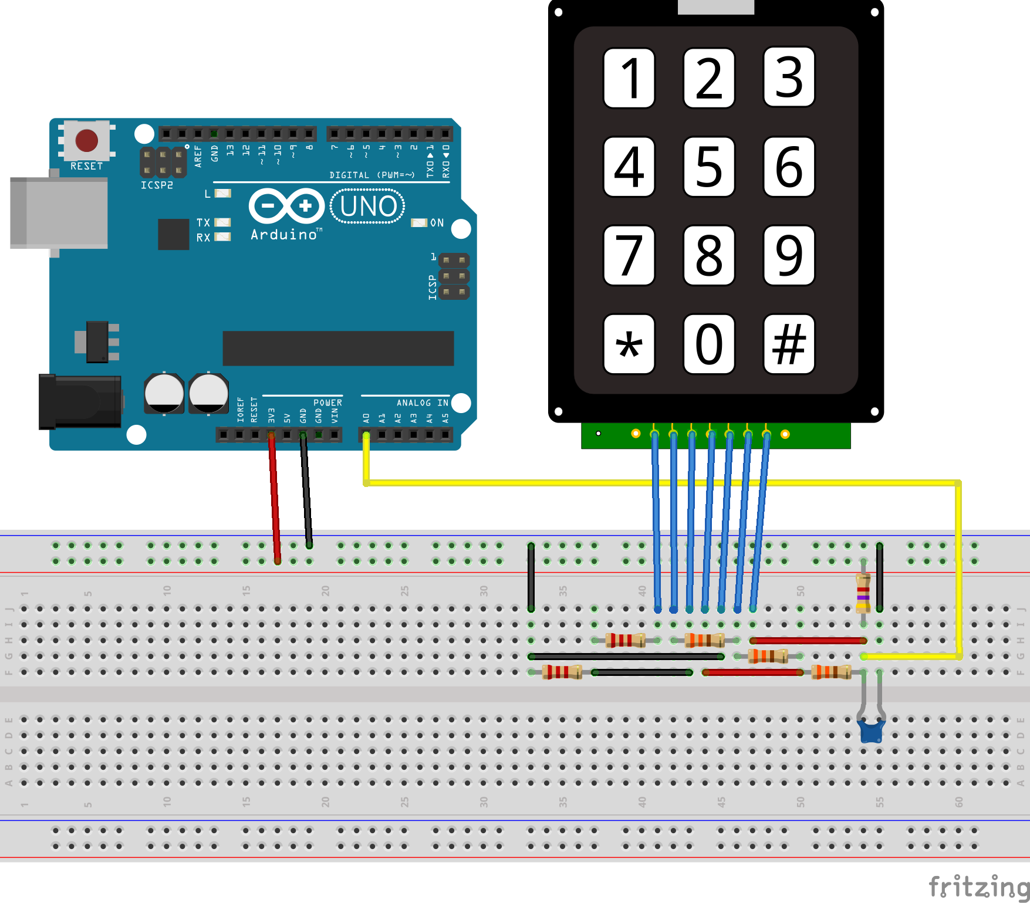
yasiru/keypad_bb.png
