Team-Sagittarius-ENTC/RGBsensor/yasiru/rgb-led-circuit.png

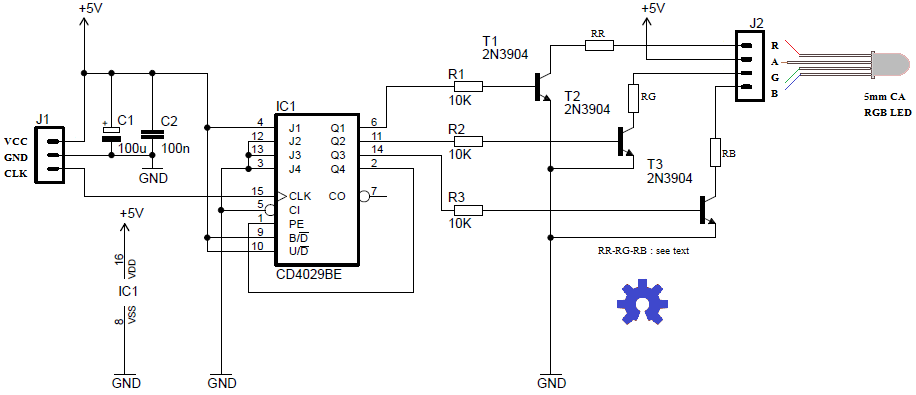
yasiru/rgb-led-circuit.png
