Team-Sagittarius-ENTC/RGBsensor/prabhashwara/ENCLOSURE-2/mainBox_2.SLDPRT

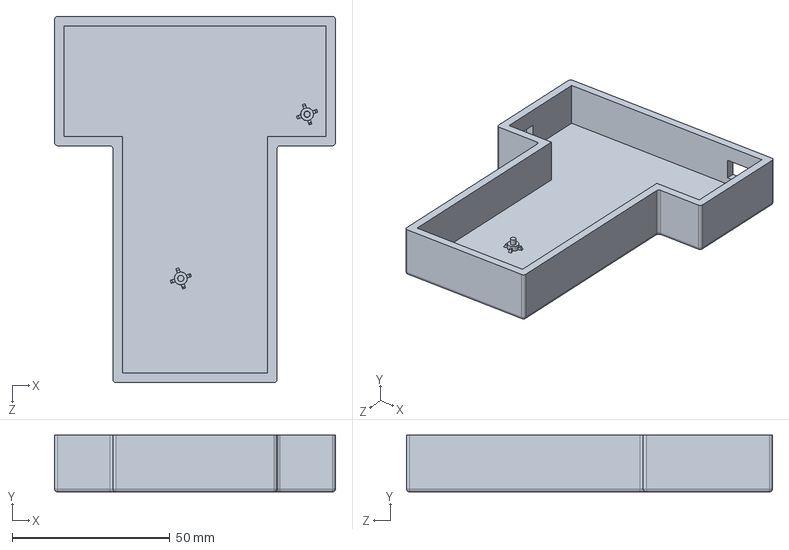
[picture p64: CAD file, 2021-08-07]
prabhashwara/ENCLOSURE-2/mainBox_2.SLDPRT
89.0 x 18.0 x 116.0 mm
