Team-Sagittarius-ENTC/RGBsensor/prabhashwara/final-organized-enclosure/box-for-proccessor-1.SLDASM

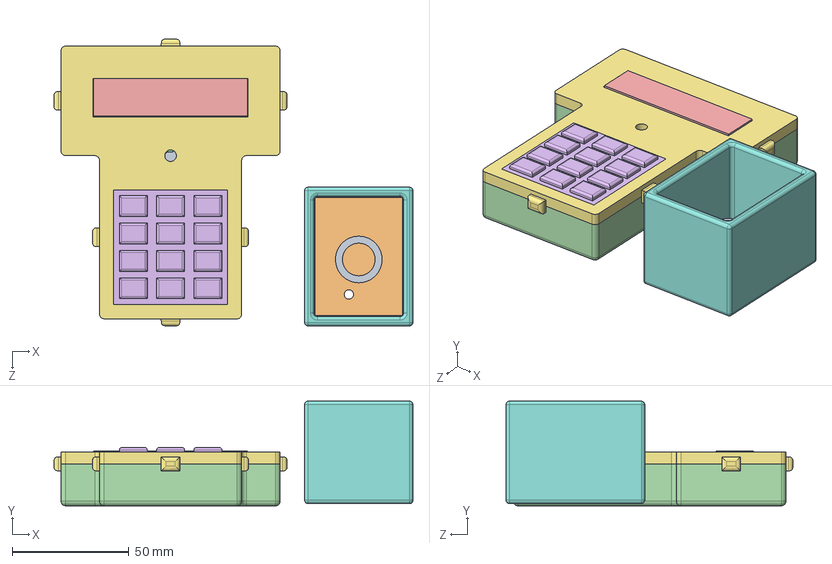
[picture p65: CAD file, 2021-08-09]
prabhashwara/final-organized-enclosure/box-for-proccessor-1.SLDASM
154.0 x 44.9 x 123.0 mm
Extruded.step
Extruded-0.step
Extruded-1.step
BODY_N0016A_AF0.step
Texas_Logo_Yury.step
Texas_Logo_Yury2.step
Extruded-3.step
BOUR-TC33X-2_2.step
1.step
2.step
3.step
IRF_logo.step
User_Library-NEB21R.step
Open_CASCADE_STEP_translator_6.8_36.1.1.step
Open_CASCADE_STEP_translator_6.8_36.2.1.step
lead.step x 2
Extruded-5.step
Extruded-6.step x 2
outerBox3
displayReplica
keypadReplica
top
sensor_part
sensor_cover
sensor_pcb_replica
