Team-Sagittarius-ENTC/RGBsensor/prabhashwara/SOLIDWORKS_ENCLOSURE_ALIGNED/Assem95.SLDASM

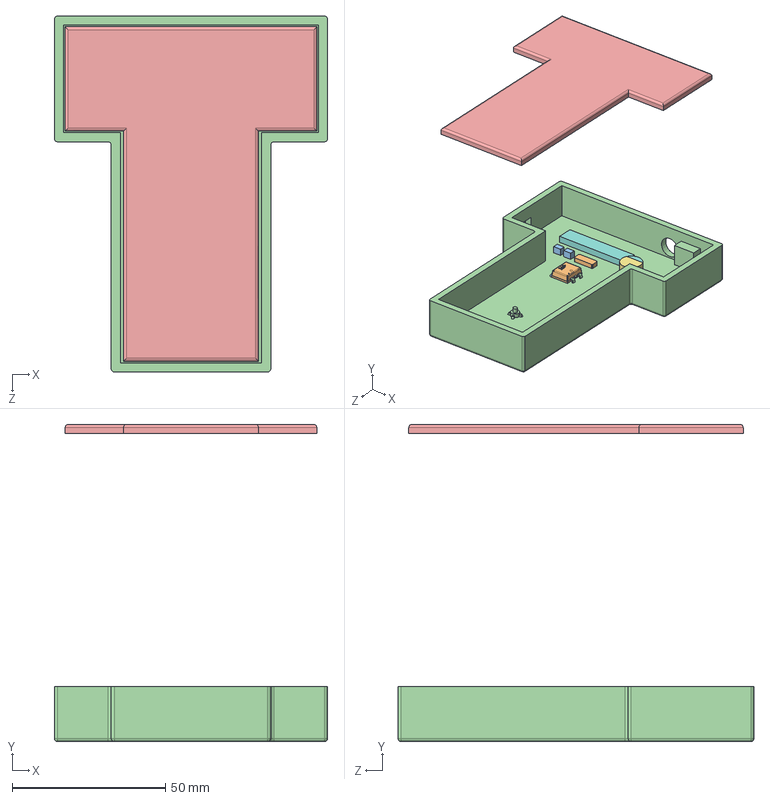
[picture p66: CAD file, 2021-08-08]
prabhashwara/SOLIDWORKS_ENCLOSURE_ALIGNED/Assem95.SLDASM
89.0 x 103.3 x 116.0 mm
Extruded.step
Extruded-0.step
Extruded-1.step
BODY_N0016A_AF0.step
Texas_Logo_Yury.step
Texas_Logo_Yury2.step
Extruded-3.step
BOUR-TC33X-2_2.step
1.step
2.step
3.step
IRF_logo.step
Open_CASCADE_STEP_translator_6.8_36.1.1.step
Open_CASCADE_STEP_translator_6.8_36.2.1.step
Open_CASCADE_STEP_translator_6.8_36.3.1.step
lead.step x 2
Extruded-5.step
Extruded-6.step x 2
mainBox_2_aligned_hole for power
mainBoxTop
