Team-Sagittarius-ENTC/RGBsensor/prabhashwara/ENCLOSURE-2/temp/mainBox.SLDPRT

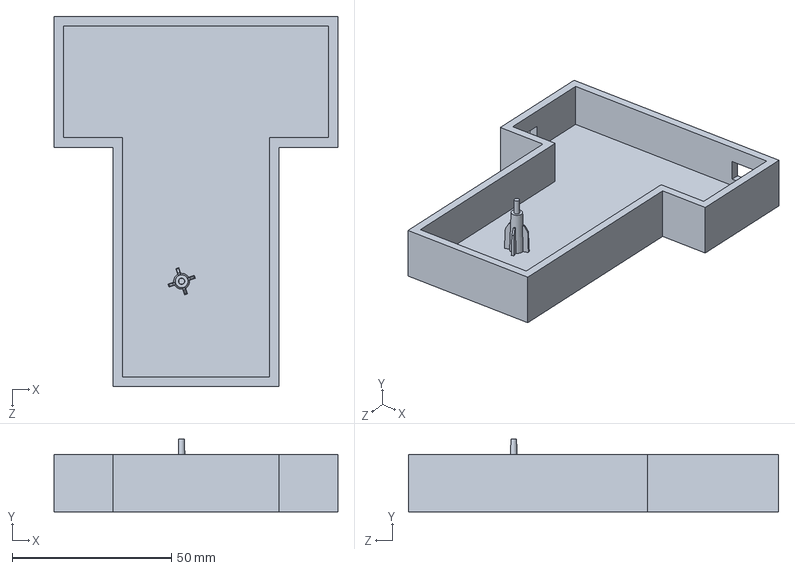
[picture p68: CAD file, 2021-08-07]
prabhashwara/ENCLOSURE-2/temp/mainBox.SLDPRT
89.0 x 22.7 x 116.0 mm
