Team-Sagittarius-ENTC/RGBsensor/prabhashwara/final-organized-enclosure/SENSOR/sensor_assembly.SLDASM

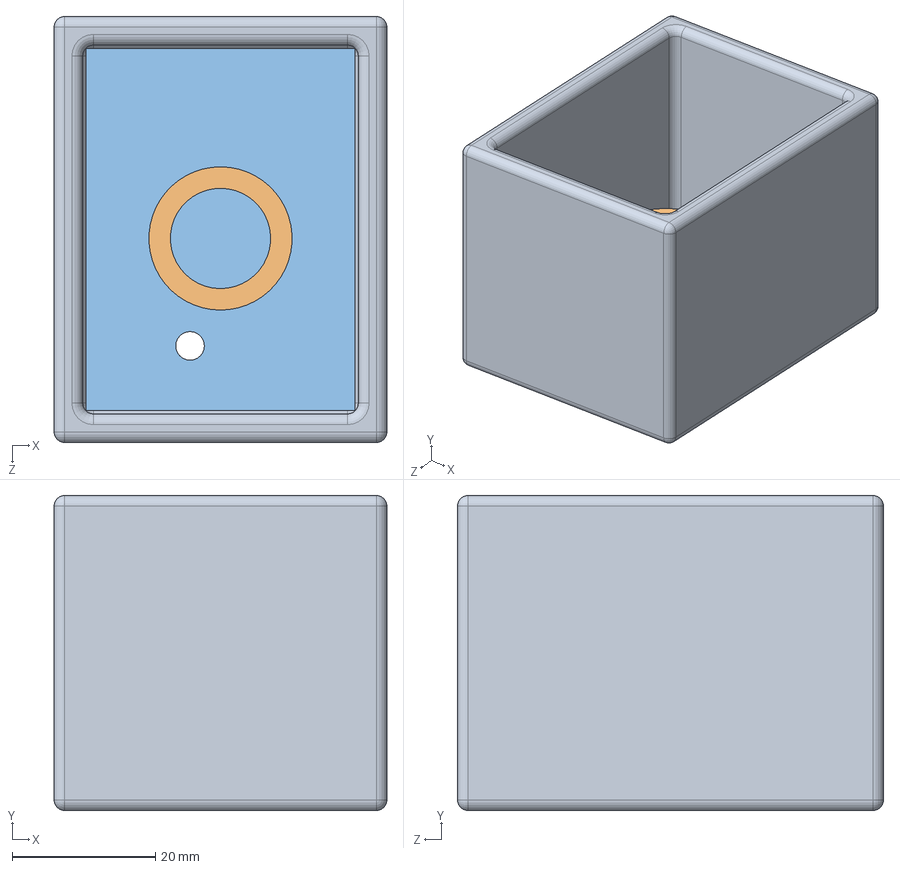
[picture p69: CAD file, 2021-08-09]
prabhashwara/final-organized-enclosure/SENSOR/sensor_assembly.SLDASM
46.5 x 44.0 x 59.5 mm
sensor_part
sensor_cover
sensor_pcb_replica
