Team-Sagittarius-ENTC/RGBsensor/prabhashwara/SOLIDWORKS_ENCLOSURE_ALIGNED/RGB_pcb.step.SLDASM

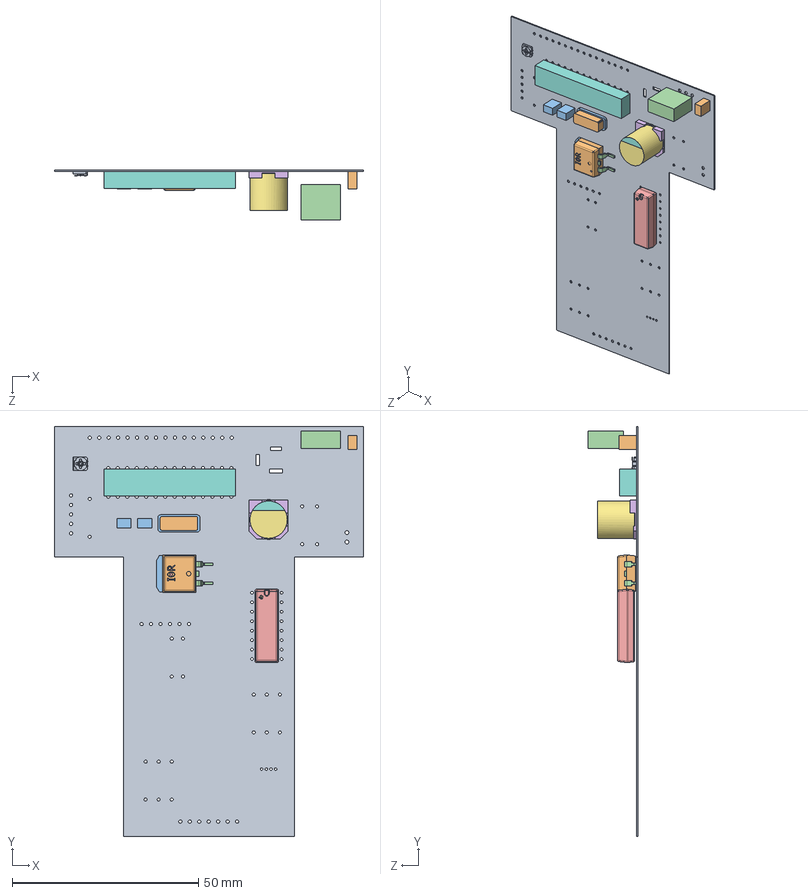
[picture p70: CAD file, 2021-08-08]
prabhashwara/SOLIDWORKS_ENCLOSURE_ALIGNED/RGB_pcb.step.SLDASM
83.0 x 110.0 x 13.5 mm
Extruded.step
Extruded-0.step
Extruded-1.step
BODY_N0016A_AF0.step
Texas_Logo_Yury.step
Texas_Logo_Yury2.step
Extruded-3.step
BOUR-TC33X-2_2.step
1.step
2.step
3.step
IRF_logo.step
Open_CASCADE_STEP_translator_6.8_36.1.1.step
Open_CASCADE_STEP_translator_6.8_36.2.1.step
Open_CASCADE_STEP_translator_6.8_36.3.1.step
lead.step x 2
Extruded-5.step
Extruded-6.step x 2
