Team-Sagittarius-ENTC/RGBsensor/prabhashwara/SOLIDWORKS_ENCLOSURE_ALIGNED/mainBoxTop.SLDPRT

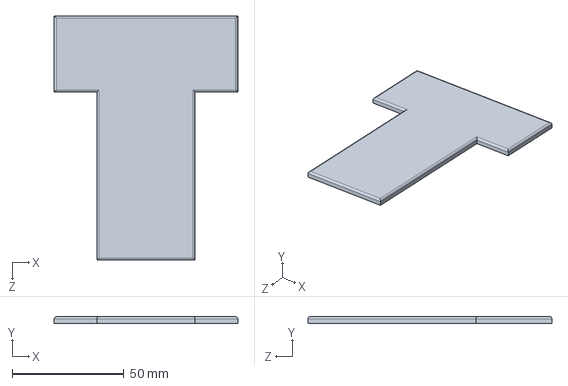
[picture p71: CAD file, 2021-08-08]
prabhashwara/SOLIDWORKS_ENCLOSURE_ALIGNED/mainBoxTop.SLDPRT
82.0 x 3.00 x 109.0 mm
