Team-Sagittarius-ENTC/RGBsensor/prabhashwara/ENCLOSURE-2/temp/Assem63._rekiSLDASM.SLDASM

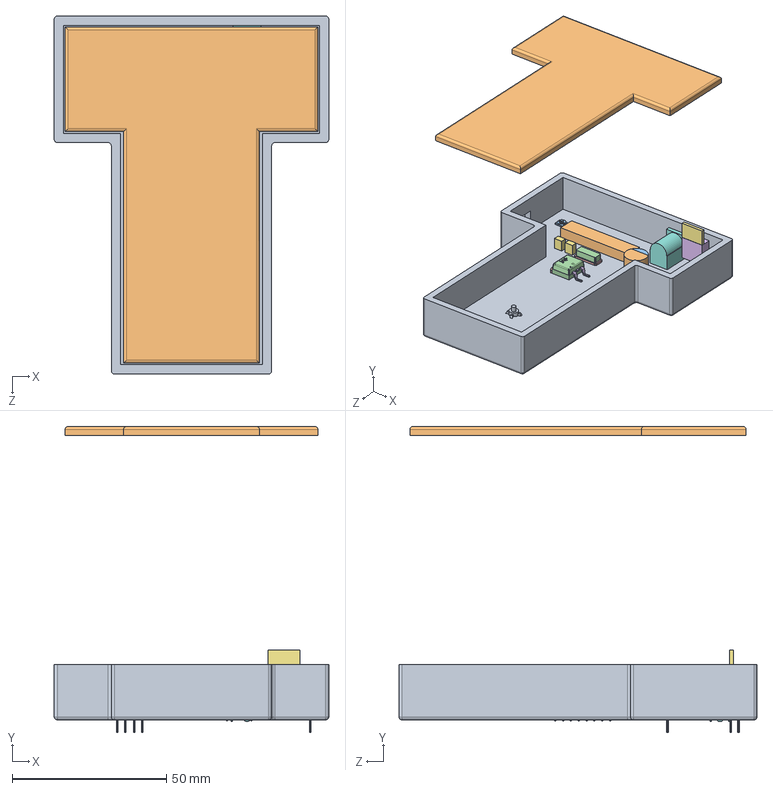
[picture p72: CAD file, 2021-08-07]
prabhashwara/ENCLOSURE-2/temp/Assem63._rekiSLDASM.SLDASM
89.0 x 99.2 x 116.0 mm
mainBox_2_aligned_hole for power
mainBoxTop
Extruded.step
Extruded-0.step
Extruded-1.step
Extruded-2.step
LEAD_N0016A_AF0.step
LEAD_N0016A.step x 10
LEAD_N0016A_AF2.step
LEAD_N0016A_AF4.step
LEAD_N0016A_AF1.step
LEAD_N0016A_AF3.step
LEAD_N0016A_AF5.step
BODY_N0016A_AF0.step
Texas_Logo_Yury.step
Texas_Logo_Yury2.step
Extruded-3.step
BOUR-TC33X-2_2.step
1.step
2.step
3.step
IRF_logo.step
User_Library-NEB21R.step
Open_CASCADE_STEP_translator_6.8_36.1.1.step
Open_CASCADE_STEP_translator_6.8_36.2.1.step
Open_CASCADE_STEP_translator_6.8_36.3.1.step
lead.step x 2
Extruded-4.step x 6
Extruded-5.step
Extruded-6.step x 2
