Team-Sagittarius-ENTC/RGBsensor/prabhashwara/final-organized-enclosure/SENSOR/sensor_part.SLDPRT

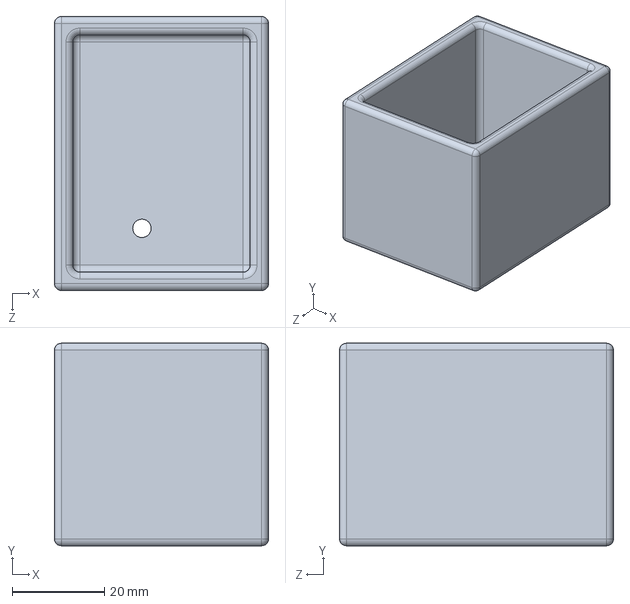
[picture p74: CAD file, 2021-08-09]
prabhashwara/final-organized-enclosure/SENSOR/sensor_part.SLDPRT
46.5 x 44.0 x 59.5 mm
