Team-Sagittarius-ENTC/RGBsensor/prabhashwara/SENSOR/sensor_pcb_replica.SLDPRT

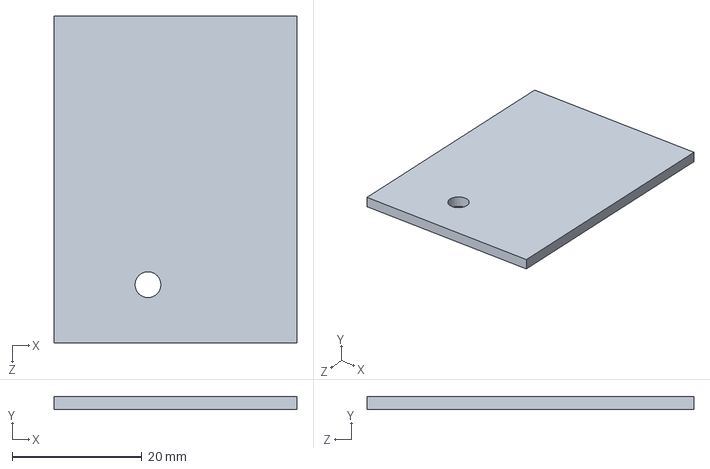
[picture p75: CAD file, 2021-08-09]
prabhashwara/SENSOR/sensor_pcb_replica.SLDPRT
37.5 x 2.00 x 50.5 mm
