Team-Sagittarius-ENTC/RGBsensor/prabhashwara/final-organized-enclosure/displayReplica.SLDPRT

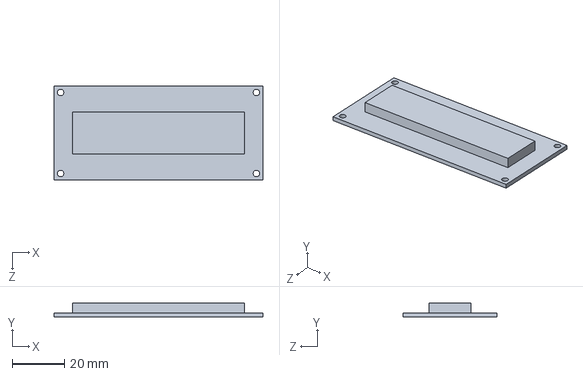
[picture p76: CAD file, 2021-08-09]
prabhashwara/final-organized-enclosure/displayReplica.SLDPRT
80.0 x 5.50 x 36.0 mm
