Team-Sagittarius-ENTC/RGBsensor/prabhashwara/from yasiru ss/EGB_Sensor/RGB_pcb.step

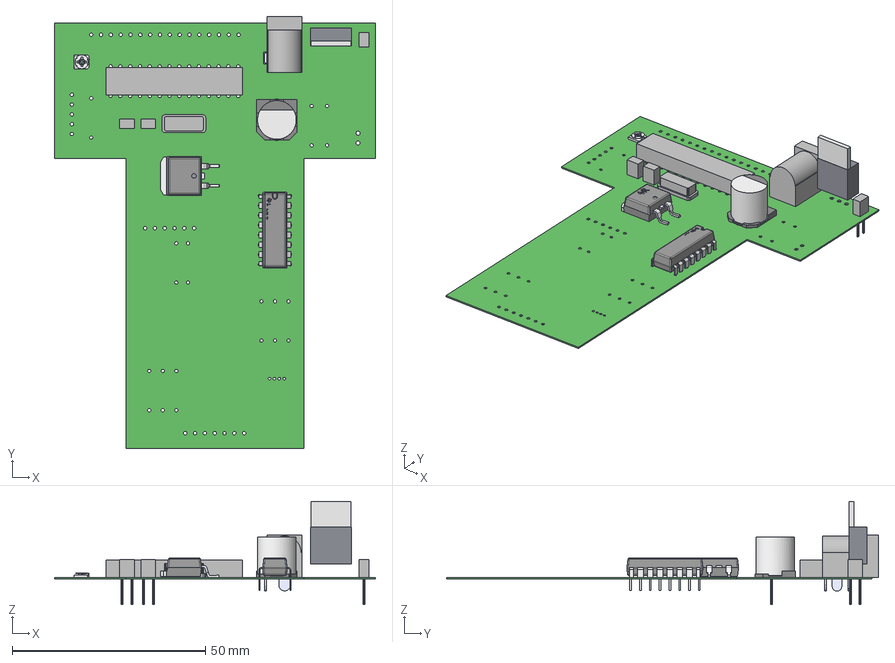
[picture p77: CAD file, 2021-08-07]
prabhashwara/from yasiru ss/EGB_Sensor/RGB_pcb.step
83.0 x 111.8 x 26.7 mm
Extruded x 14
BODY_N0016A_AF0
LEAD_N0016A_AF0
LEAD_N0016A x 10
LEAD_N0016A_AF2
LEAD_N0016A_AF4
LEAD_N0016A_AF1
LEAD_N0016A_AF3
LEAD_N0016A_AF5
Texas_Logo_Yury
Texas_Logo_Yury2
BOUR-TC33X-2_2
IRF_logo
User_Library-NEB21R
Open_CASCADE_STEP_translator_6.8_36.1.1
Open_CASCADE_STEP_translator_6.8_36.2.1
Open_CASCADE_STEP_translator_6.8_36.3.1
lead x 2
