Team-Sagittarius-ENTC/RGBsensor/prabhashwara/final-organized-enclosure/SENSOR/sensor_cover.SLDPRT

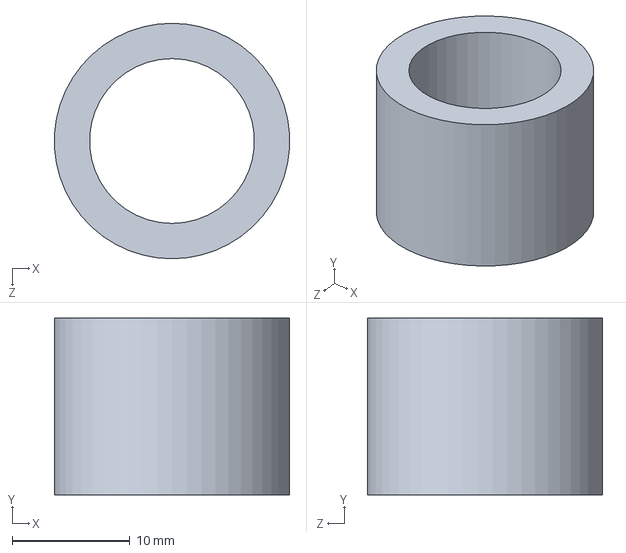
[picture p78: CAD file, 2021-08-09]
prabhashwara/final-organized-enclosure/SENSOR/sensor_cover.SLDPRT
20.0 x 15.0 x 20.0 mm
