Team-Sagittarius-ENTC/RGBsensor/prabhashwara/final-organized-enclosure/top.SLDPRT

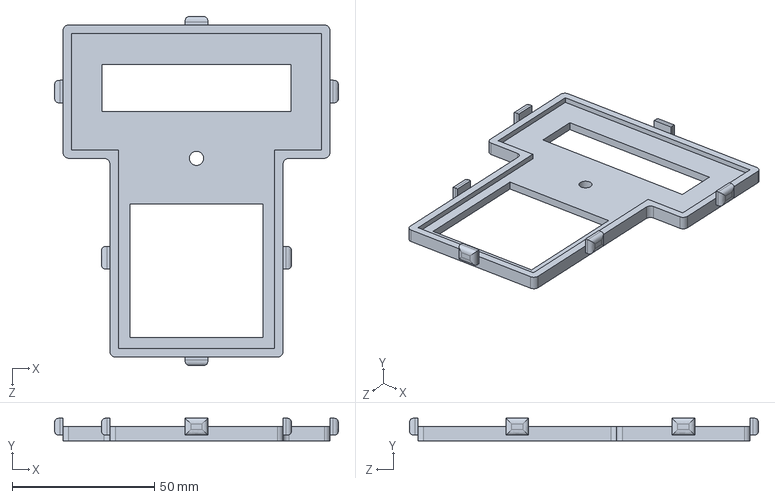
[picture p79: CAD file, 2021-08-09]
prabhashwara/final-organized-enclosure/top.SLDPRT
100.0 x 8.00 x 123.0 mm
