Team-Sagittarius-ENTC/RGBsensor/prabhashwara/final-organized-enclosure/outerBox3.SLDPRT

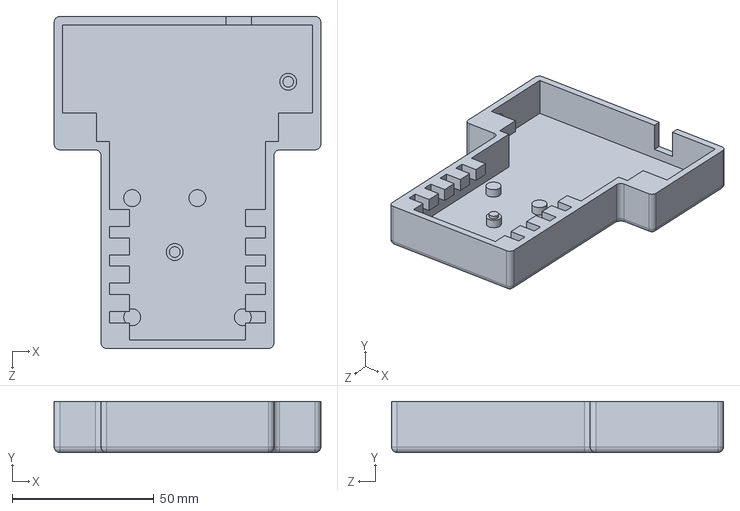
[picture p80: CAD file, 2021-08-09]
prabhashwara/final-organized-enclosure/outerBox3.SLDPRT
94.0 x 18.0 x 117.0 mm
