Team-Sagittarius-ENTC/RGBsensor/prabhashwara/final-organized-enclosure/keypadReplica.SLDPRT

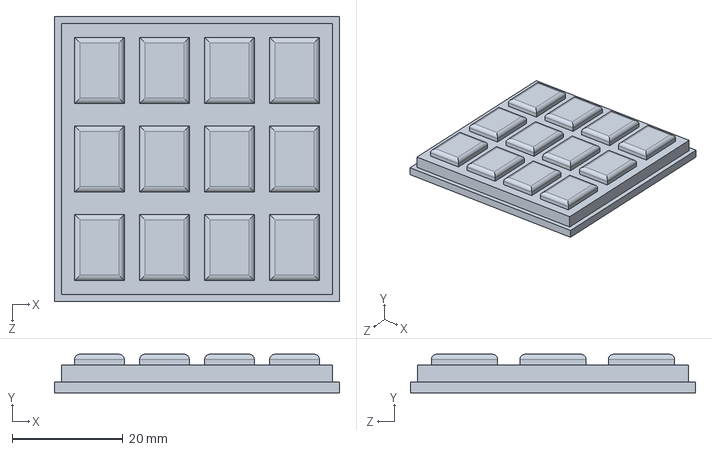
[picture p81: CAD file, 2021-08-09]
prabhashwara/final-organized-enclosure/keypadReplica.SLDPRT
51.5 x 7.00 x 51.5 mm
