Team-Sagittarius-ENTC/RGBsensor/prabhashwara/final-organized-enclosure/outerBox2.SLDPRT

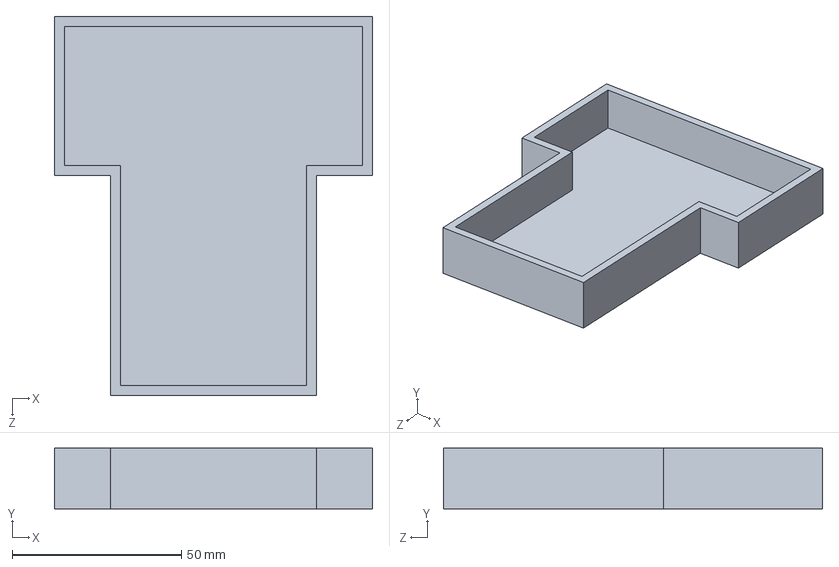
[picture p82: CAD file, 2021-08-08]
prabhashwara/final-organized-enclosure/outerBox2.SLDPRT
94.0 x 18.0 x 112.0 mm
