Team-Sagittarius-ENTC/RGBsensor/(list of files, cad)

Other CAD files:
prabhashwara/SOLIDWORKS_ENCLOSURE/IC_Texas_Instruments_CD4040BE_eec.step.SLDASM
prabhashwara/ENCLOSURE-2/mainBox_2_aligned_hole for power.SLDPRT
prabhashwara/SOLIDWORKS_ENCLOSURE/mainBoxTop.SLDPRT
prabhashwara/SOLIDWORKS_ENCLOSURE/C4.step.SLDASM
prabhashwara/SOLIDWORKS_ENCLOSURE/Y1.step.SLDASM
prabhashwara/SOLIDWORKS_ENCLOSURE/legs_1.step.SLDASM
prabhashwara/SOLIDWORKS_ENCLOSURE/Q1.step.SLDASM
prabhashwara/SOLIDWORKS_ENCLOSURE/Trans_Infineon_IRF2805STRLPBF_eec.step.SLDASM
prabhashwara/SOLIDWORKS_ENCLOSURE/mark.step.SLDASM
prabhashwara/SOLIDWORKS_ENCLOSURE/BOUR-TC33X-2.step.SLDASM
prabhashwara/SOLIDWORKS_ENCLOSURE/U3.step.SLDASM
prabhashwara/SOLIDWORKS_ENCLOSURE/RGB_pcb.step.SLDASM
prabhashwara/SOLIDWORKS_ENCLOSURE/BOUR-TC33X-2_1.step.SLDASM
prabhashwara/SOLIDWORKS_ENCLOSURE/U2.step.SLDASM
prabhashwara/SOLIDWORKS_ENCLOSURE/Board.step.SLDASM
prabhashwara/SOLIDWORKS_ENCLOSURE/J1.step.SLDASM
prabhashwara/SOLIDWORKS_ENCLOSURE/cylinder.step.SLDASM
prabhashwara/SOLIDWORKS_ENCLOSURE/C2.step.SLDASM
prabhashwara/SOLIDWORKS_ENCLOSURE/legs_2.step.SLDASM
prabhashwara/SOLIDWORKS_ENCLOSURE/U1.step.SLDASM
prabhashwara/SOLIDWORKS_ENCLOSURE/C1.step.SLDASM
prabhashwara/SOLIDWORKS_ENCLOSURE/base.step.SLDASM
prabhashwara/SOLIDWORKS_ENCLOSURE/C3.step.SLDASM
prabhashwara/SOLIDWORKS_ENCLOSURE/R5.step.SLDASM
prabhashwara/from yasiru ss/EGB_Sensor/board_shape.DWG
prabhashwara/SOLIDWORKS_ENCLOSURE/BODY_N0016A_AF0.step.SLDPRT
prabhashwara/SOLIDWORKS_ENCLOSURE/Extruded-4.step.SLDPRT
prabhashwara/SOLIDWORKS_ENCLOSURE/Extruded-1.step.SLDPRT
prabhashwara/SOLIDWORKS_ENCLOSURE/LEAD_N0016A.step.SLDPRT
prabhashwara/final-organized-enclosure/outerBox.SLDPRT
prabhashwara/SOLIDWORKS_ENCLOSURE/LEAD_N0016A_AF4.step.SLDPRT
prabhashwara/SOLIDWORKS_ENCLOSURE/3.step.SLDPRT
prabhashwara/SOLIDWORKS_ENCLOSURE/Open_CASCADE_STEP_translator_6.8_36.3.1.step.SLDPRT
prabhashwara/SOLIDWORKS_ENCLOSURE/Extruded-0.step.SLDPRT
prabhashwara/SOLIDWORKS_ENCLOSURE/Extruded-5.step.SLDPRT
prabhashwara/SOLIDWORKS_ENCLOSURE/2.step.SLDPRT
prabhashwara/SOLIDWORKS_ENCLOSURE/lead.step.SLDPRT
prabhashwara/SOLIDWORKS_ENCLOSURE/Extruded.step.SLDPRT
prabhashwara/SOLIDWORKS_ENCLOSURE/Open CASCADE STEP translator 6.8 2.1.1.step.SLDPRT
prabhashwara/SOLIDWORKS_ENCLOSURE/LEAD_N0016A_AF5.step.SLDPRT
prabhashwara/SOLIDWORKS_ENCLOSURE/LEAD_N0016A_AF1.step.SLDPRT
prabhashwara/SOLIDWORKS_ENCLOSURE/Texas_Logo_Yury.step.SLDPRT
prabhashwara/SOLIDWORKS_ENCLOSURE/User_Library-NEB21R.step.SLDPRT
prabhashwara/SOLIDWORKS_ENCLOSURE/Texas_Logo_Yury2.step.SLDPRT
prabhashwara/SOLIDWORKS_ENCLOSURE/Open_CASCADE_STEP_translator_6.8_36.2.1.step.SLDPRT
prabhashwara/SOLIDWORKS_ENCLOSURE/Extruded-2.step.SLDPRT
prabhashwara/SOLIDWORKS_ENCLOSURE/LEAD_N0016A_AF3.step.SLDPRT
prabhashwara/SOLIDWORKS_ENCLOSURE/IRF_logo.step.SLDPRT
prabhashwara/SOLIDWORKS_ENCLOSURE/LEAD_N0016A_AF0.step.SLDPRT
prabhashwara/SOLIDWORKS_ENCLOSURE/Extruded-3.step.SLDPRT
prabhashwara/SOLIDWORKS_ENCLOSURE/Extruded-6.step.SLDPRT
prabhashwara/SOLIDWORKS_ENCLOSURE/LEAD_N0016A_AF2.step.SLDPRT
prabhashwara/SOLIDWORKS_ENCLOSURE/BOUR-TC33X-2_2.step.SLDPRT
prabhashwara/SOLIDWORKS_ENCLOSURE/1.step.SLDPRT
prabhashwara/SOLIDWORKS_ENCLOSURE/Open_CASCADE_STEP_translator_6.8_36.1.1.step.SLDPRT
prabhashwara/SOLIDWORKS_ENCLOSURE/5332539584.step.SLDASM
prabhashwara/SOLIDWORKS_ENCLOSURE/6112361632.step.SLDASM
prabhashwara/SOLIDWORKS_ENCLOSURE/6394512256.step.SLDASM
prabhashwara/SOLIDWORKS_ENCLOSURE/6691727136.step.SLDASM
prabhashwara/SOLIDWORKS_ENCLOSURE/7155368784.step.SLDASM
prabhashwara/SOLIDWORKS_ENCLOSURE/7155368944.step.SLDASM
prabhashwara/SOLIDWORKS_ENCLOSURE/7165104592.step.SLDASM
prabhashwara/SOLIDWORKS_ENCLOSURE/7509442176.step.SLDASM
prabhashwara/SOLIDWORKS_ENCLOSURE/7523570864.step.SLDASM
prabhashwara/final-organized-enclosure/outerBox3 - Copy (2).SLDPRT
prabhashwara/final-organized-enclosure/outerBox3 - Copy (3).SLDPRT
prabhashwara/final-organized-enclosure/outerBox3 - Copy (4).SLDPRT
prabhashwara/final-organized-enclosure/outerBox3 - Copy (5).SLDPRT
prabhashwara/final-organized-enclosure/outerBox3 - Copy.SLDPRT
