Team-Sagittarius-ENTC/RGBsensor/prabhashwara/from yasiru ss/instructions page 24.png

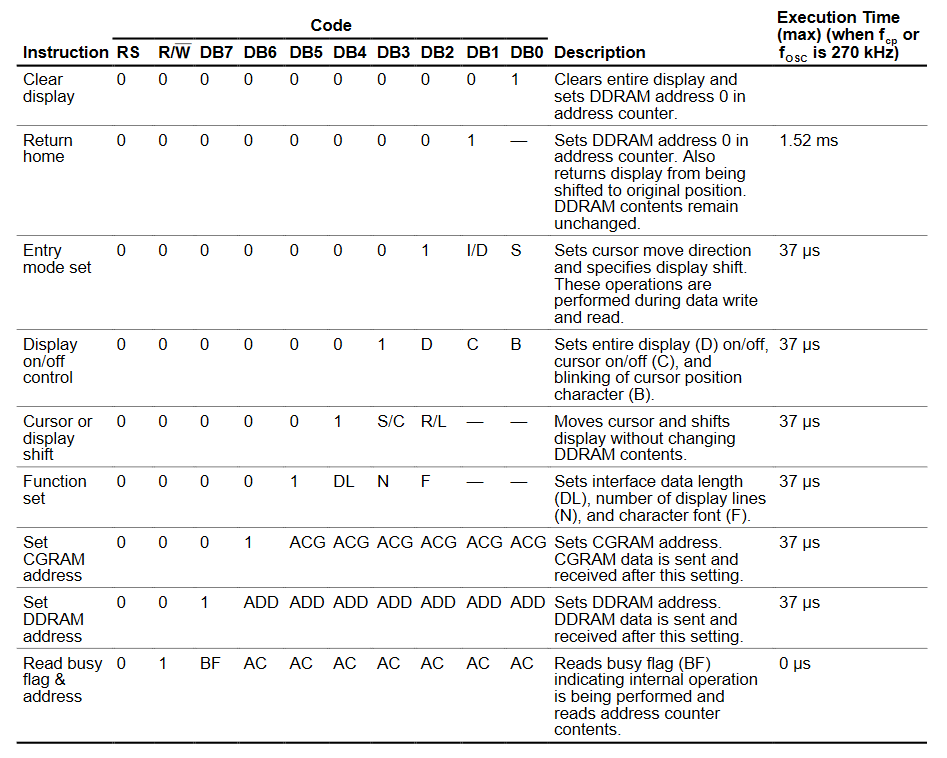
prabhashwara/from yasiru ss/instructions page 24.png
