Team-Sagittarius-ENTC/RGBsensor/firmware/Optional/Calibrated Tests/Dark Green.png

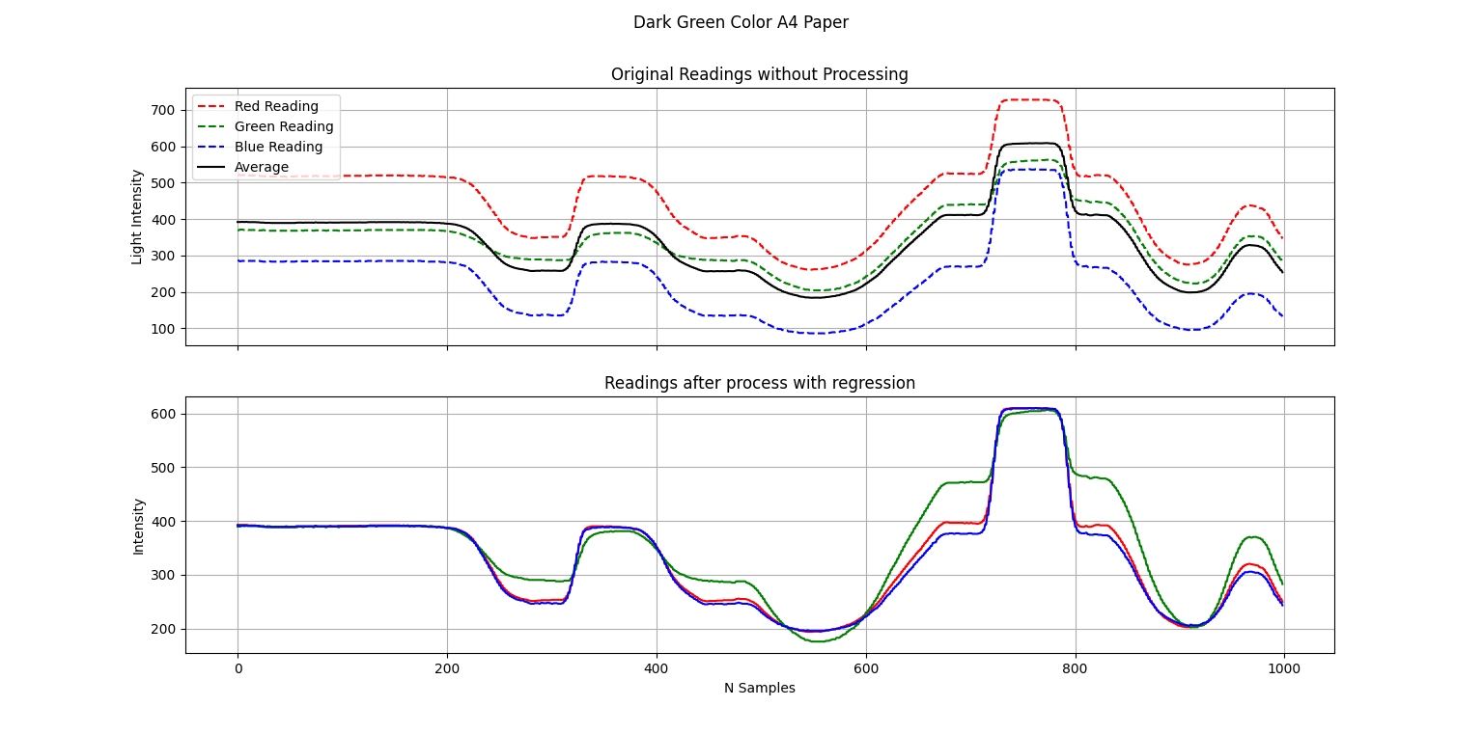
firmware/Optional/Calibrated Tests/Dark Green.png
