Team-Sagittarius-ENTC/RGBsensor/firmware/Optional/Calibrated Tests/Light Green.png

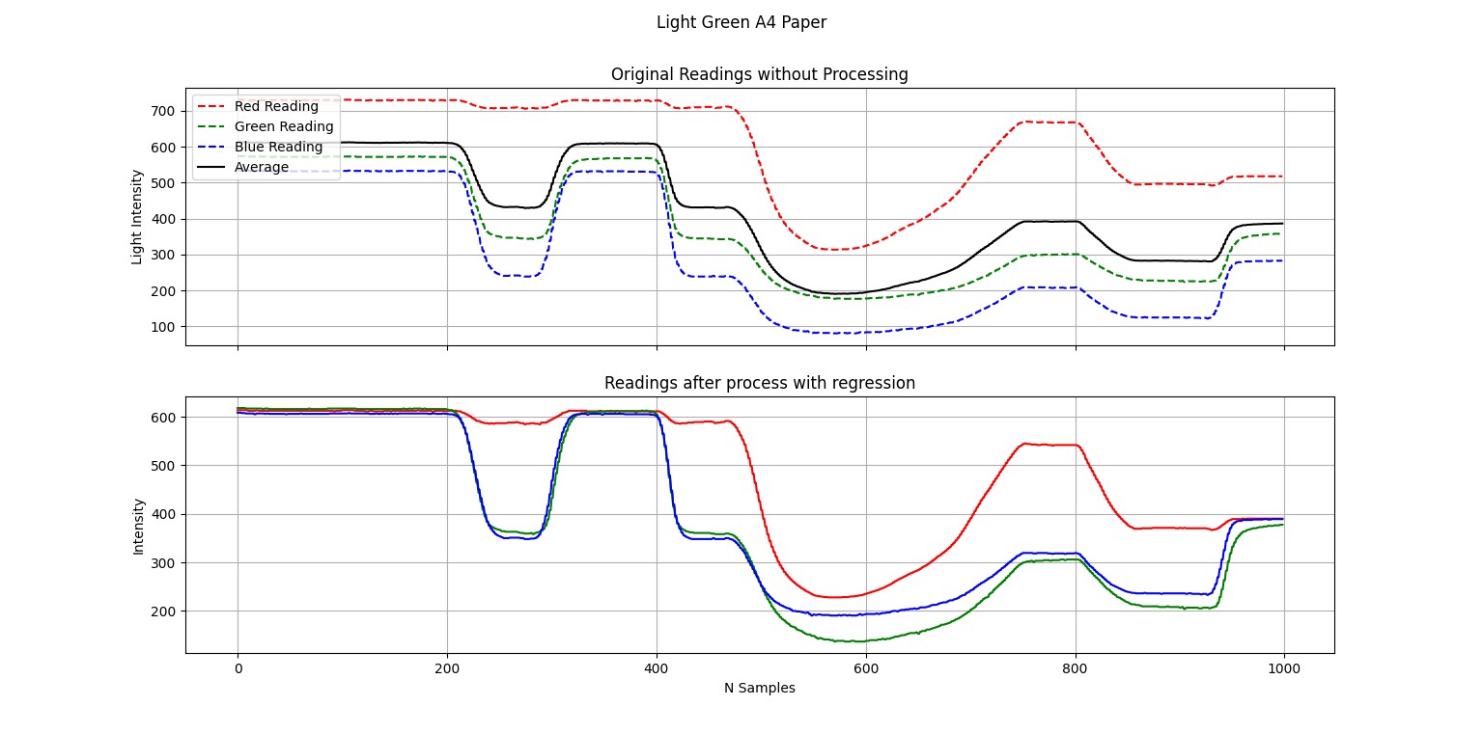
firmware/Optional/Calibrated Tests/Light Green.png
