Team-Sagittarius-ENTC/RGBsensor/firmware/Optional/Calibrated Tests/Red Color.png

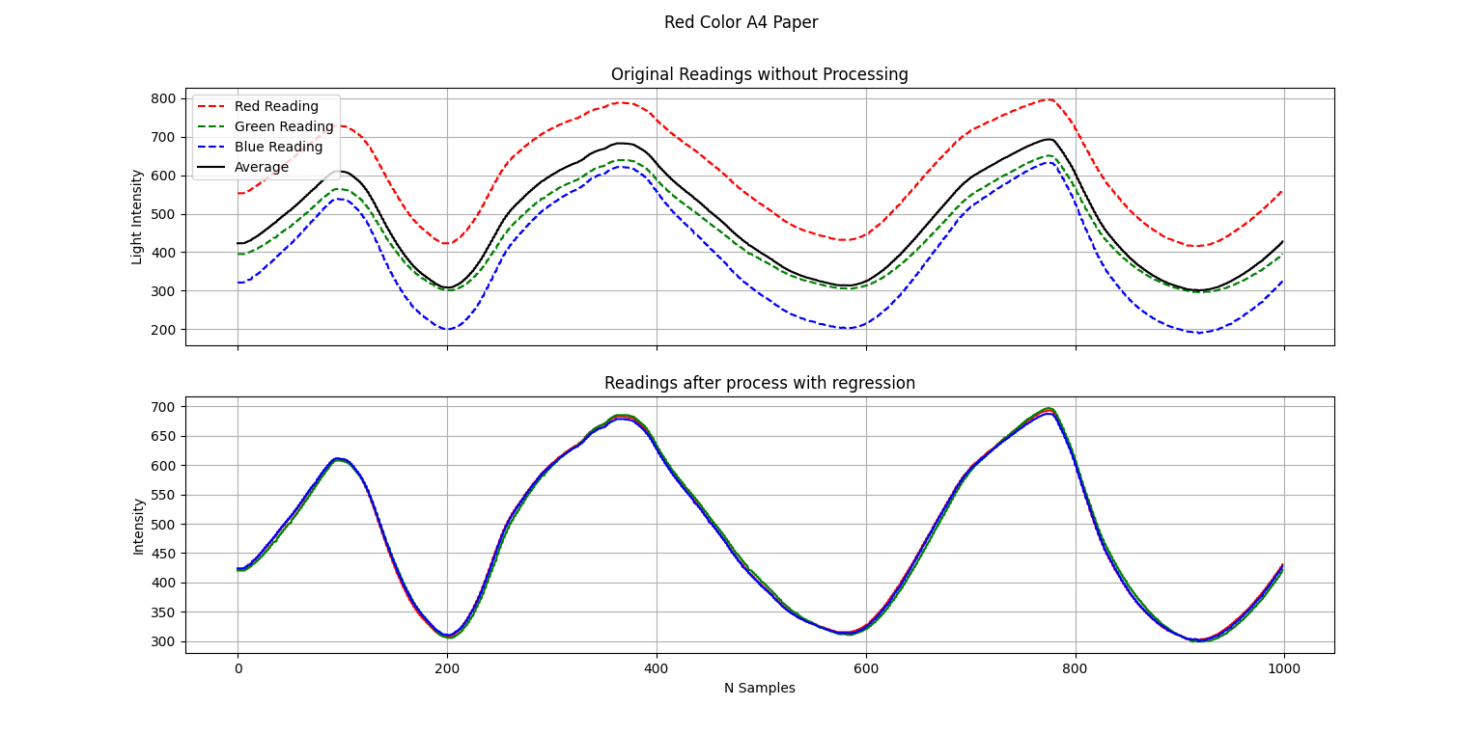
firmware/Optional/Calibrated Tests/Red Color.png
