Team-Sagittarius-ENTC/RGBsensor/firmware/Optional/Calibrated Tests/Sensor Calibrated Charisteristics.png

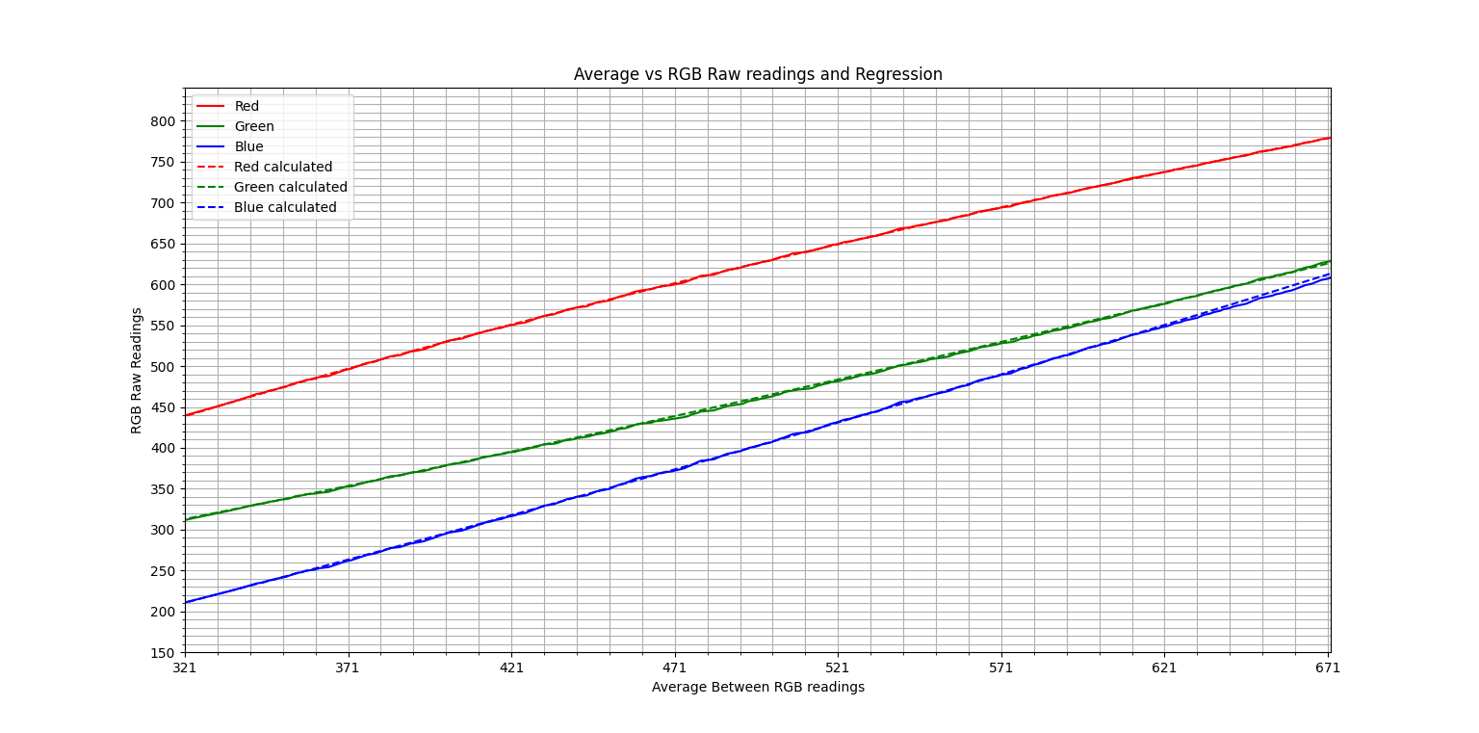
firmware/Optional/Calibrated Tests/Sensor Calibrated Charisteristics.png
