Team-Sagittarius-ENTC/RGBsensor/prabhashwara/from yasiru ss/EGB_Sensor/EGB_Sensor.pdf

### ATMEGA328-PU IC connection

### RGB Led Lighting 4:1 Demux Connection

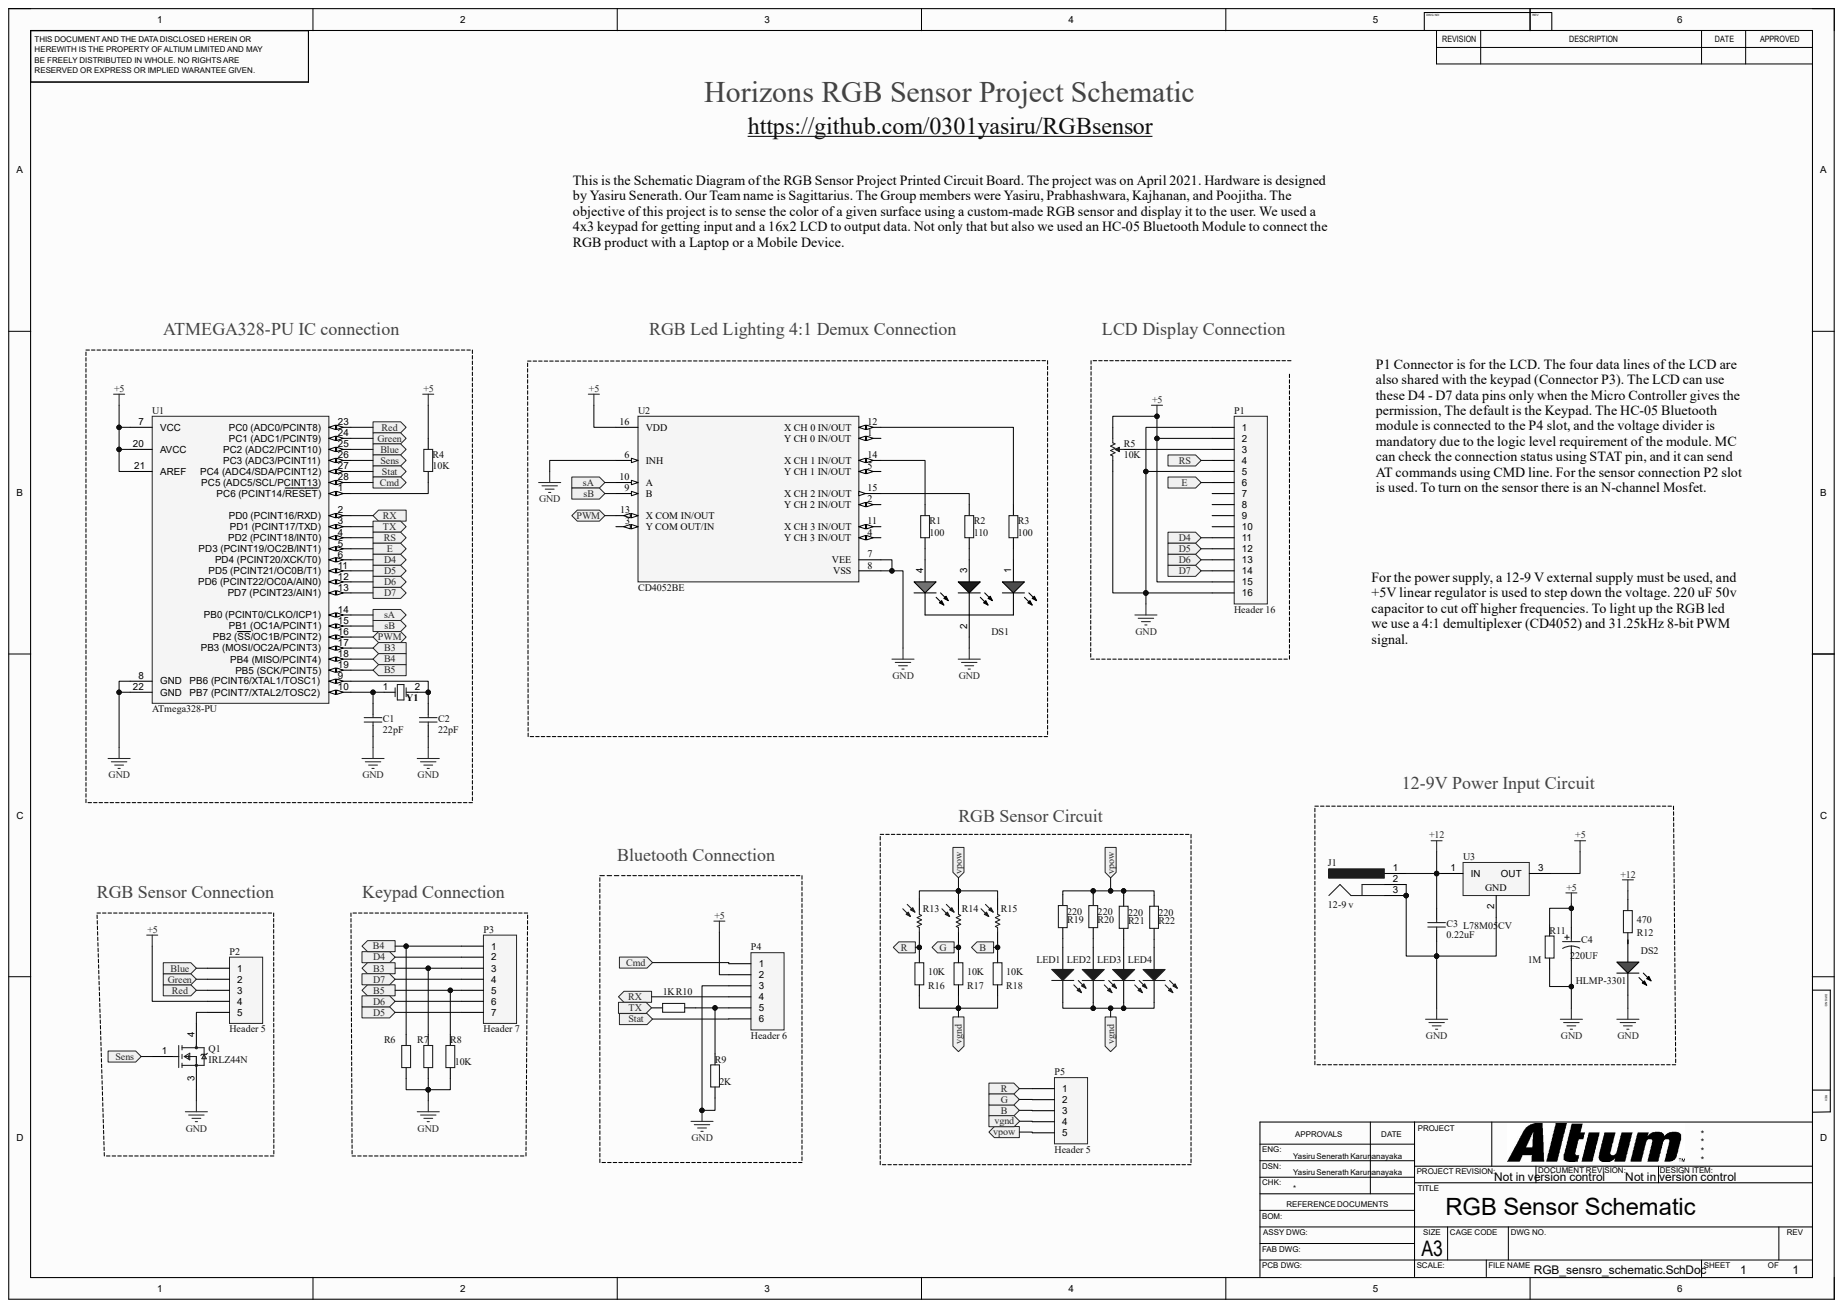
[picture p88: page 1]

1 | 2 | 3 | 4 | 5 | DWG NO: | REV: | 6

THIS DOCUMENT AND THE DATA DISCLOSED HEREIN OR HEREWITH IS THE PROPERTY OF ALTIUM LIMITED AND MAY BE FREELY DISTRIBUTED IN WHOLE. NO RIGHTS ARE RESERVED OR EXPRESS OR IMPLIED WARANTEE GIVEN. | +5 +5 | REVISION | DESCRIPTION | DATE | APPROVED

Horizons RGB Sensor Project Schematic
https://github.com/0301yasiru/RGBsensor

This is the Schematic Diagram of the RGB Sensor Project Printed Circuit Board. The project was on April 2021. Hardware is designed
by Yasiru Senerath. Our Team name is Sagittarius. The Group members were Yasiru, Prabhashwara, Kajhanan, and Poojitha. The
objective of this project is to sense the color of a given surface using a custom-made RGB sensor and display it to the user. We used a
4x3 keypad for getting input and a 16x2 LCD to output data. Not only that but also we used an HC-05 Bluetooth Module to connect the
RGB product with a Laptop or a Mobile Device.

P1 Connector is for the LCD. The four data lines of the LCD are
also shared with the keypad (Connector P3). The LCD can use
these D4 - D7 data pins only when the Micro Controller gives the
permission, The default is the Keypad. The HC-05 Bluetooth
module is connected to the P4 slot, and the voltage divider is
mandatory due to the logic level requirement of the module. MC
can check the connection status using STAT pin, and it can send
AT commands using CMD line. For the sensor connection P2 slot
is used. To turn on the sensor there is an N-channel Mosfet.

For the power supply, a 12-9 V external supply must be used, and
+5V linear regulator is used to step down the voltage. 220 uF 50v
capacitor to cut off higher frequencies. To light up the RGB led
we use a 4:1 demultiplexer (CD4052) and 31.25kHz 8-bit PWM
signal.

ENG: Yasiru Senerath Karunanayaka
DSN: Yasiru Senerath Karunanayaka | PROJECT REVISION: | DOCUMENT REVISION: Not in version control | DESIGN ITEM: Not in version control
CHK: *
