Team-Sagittarius-ENTC/RGBsensor/(list of files, drawings)

Other design files:
kajhanan/I2C backpack proteus/New Project.pdsprj
LCD_code/AnalogReadCode/simmulation.pdsprj
LCD_code/combined_simmulation.pdsprj
LCD_code/LCD Code with New Callibration menuw/firmware_copied/combined_simmulation.pdsprj
LCD_code/simmulation.pdsprj
poojitha/keypad_LCD.pdsprj
poojitha/keypad_res_I2C_LCD.pdsprj
prabhashwara/from yasiru ss/EGB_Sensor/EGB_Sensor.PrjPcb
prabhashwara/from yasiru ss/EGB_Sensor/RGB_pcb.PcbDoc
prabhashwara/from yasiru ss/EGB_Sensor/RGB_sensro_schematic.SchDoc
prabhashwara/PROTEOUS/1_ldr_3_color_light_source.pdsprj
prabhashwara/PROTEOUS/arduino_for_sensor.pdsprj
yasiru/proteous/New Project.pdsprj
yasiru/proteous/rgbserial.pdsprj
