Team-Sagittarius-ENTC/RGBsensor/AVR_Codes/RGB_Sensor_Project_Final_AVR_code/RGB_Sensor_Project_Final_AVR_code/RGBled.h

#ifndef rgbled_definition
#define rgbled_definition
#include <util/_delay_ms.h>

class RGBled
{

	private:
	void initRGB();
	void setDutyCycle(short dutyVal);
	
	
	public:
	RGBled();
	void lightLED(int color[]);
	void offLED();

};//end of RGBled class



#endif
