Team-Sagittarius-ENTC/RGBsensor/LCD_code/LCD Code with New Callibration menuw/firmware_copied/Display.h

/*
  RGB Sensor Project
  ==================

  This is the Header file for the display liblary.
  Programmed By: Kajhanan Kailainathan 190286M
*/

#ifndef DisplayFunctions
#define DisplayFunctions

#include <Arduino.h>
#include <LiquidCrystal.h>
#include "keypad.h"
#include "RGBled.h"

class Display{
    private:
      LiquidCrystal lcd = LiquidCrystal(2,3,4,5,6,7);
      
      byte keypadPin;
      String tempInput = "";
      byte ldrPins[3] = {A2, A1, A1};
      RGBled theLed;
      int temp[3]{};
      int inputColor();
      
    public:
      //define the constructor
      Display(byte pin);
      int  color[3]{};

      // Define public messages
      void printMsg(String message, byte alignment = 0, bool line = 0);
      int inputColor(byte positionx, byte positiony, Keypad keypad);

      // define menus
      void printMainMenu();
      void printSensorMenu();
      void printCallibrationMenu();
      void printRGBMenu();
      void clear_();
      void blink_(bool status_);
      void setCursor_(byte x, byte y);
      void print_(String data);
      int* colorInputDisplay(Keypad keypad, bool halt = true);
      void printLiveSense(int color_[], bool RGB=false);
};

#endif
