Team-Sagittarius-ENTC/RGBsensor/LCD_code/LCD Code with New Callibration menuw/firmware_copied/RGBled.h

#ifndef rgbled_definition
#define rgbled_definition
#include <Arduino.h>

class RGBled
{

  private:
    void initRGB();
    void setDutyCycle(byte dutyVal);
    
  
  public:
    RGBled();
    void lightLED(int color[]);
    void offLED();

};//end of RGBled class



#endif
