Team-Sagittarius-ENTC/RGBsensor/LCD_code/LCD Code with New Callibration menuw/firmware_copied/bluetooth.h

#ifndef BLUETOOTH_FUNCTIONS
#define BLUETOOTH_FUNCTIONS

class Bluetooth{
  private:
    byte EN = 4;
    byte STAT = 5;
    
  public:
    Bluetooth();
    bool isOn();
    String sendCommand(String Command);
};

#endif
