Team-Sagittarius-ENTC/RGBsensor/(commit log)

2021-04-01 555 timer datasheet added
2021-04-01 created test files 2
    [test3.xlsx]
2021-04-02 Started arduino coding
2021-04-02 Arduino code added comments
2021-04-06 Arduino step 1
    [New Project.pdsprj]
2021-04-07 Arduino sensor now intermediate we can see colors in the monitor
    [New Project.pdsprj]
2021-04-07 Added flow charts for the sensing part
2021-04-08 added flowchart and experimental setup
    [1_ldr_3_color_light_source.pdsprj, arduino_for_sensor.pdsprj, test3.xlsx]
2021-04-08 with const
    [1_ldr_3_color_light_source.pdsprj]
2021-04-24 New updates
    [rgbserial.pdsprj]
2021-04-27 Resistor based keypad & I2C LCD
    [keypad_res_I2C_LCD.pdsprj]
2021-05-01 Did regression on sensors and it is working fine
2021-05-04 Sensor Regression done and sensor reading done.
    [dump.txt]
2021-05-04 Sensor Regression done and sensor reading done. Comments added
2021-05-13 Keyboard liblary added to firmware folder
    [combined_simmulation.pdsprj]
2021-05-17 LCD code added to the root directory
    [simmulation.pdsprj]
2021-05-18 added RGB LED class - controll with 1 PWM
2021-05-18 I2C Proteus
    [New Project.pdsprj]
2021-05-18 RGB LED - 1 pwm Class cretated ... & presentation
2021-05-27 Bluetooth IFACE begining
    [combined_simmulation.pdsprj]
2021-06-01 Firmware updated with new Keyboard
    [combined_simmulation.pdsprj]
2021-06-02 EEdited at calibration
2021-08-06 Before Editing RGB sensor code after examinations
2021-08-07 Solidworks - enclosure experimental
    [Assem2.SLDASM, mainBox.SLDPRT, mainBoxTop.SLDPRT, mainBox_2.SLDPRT]
2021-08-07 assembled pcb and main box parts --- have to connect sensor and fix the top-lid
    [1.step.SLDPRT, 2.step.SLDPRT, 3.step.SLDPRT, 5332539584.step.SLDASM, 6112361632.step.SLDASM, 6394512256.step.SLDASM, 6691727136.step.SLDASM, 7155368784.step.SLDASM]
2021-08-08 well aligned box - half way
    [Assem2.SLDASM, Assem63._rekiSLDASM.SLDASM, Assem95.SLDASM, EGB_Sensor.PrjPcb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]
2021-08-08 Half way on display code
    [simmulation.pdsprj]
2021-08-08 display, keyboard replicas with correct dimensions added
    [box-for-proccessor-1.SLDASM, displayReplica.SLDPRT, keypadReplica.SLDPRT, outerBox3 - Copy (3).SLDPRT, outerBox3 - Copy (4).SLDPRT, outerBox3.SLDPRT, top.SLDPRT]
2021-08-08 LCD code is done. Fully debugged. No Errors or Warnings. All Fixed :)
    [Arduino_code.ino, Display.cpp, Display.h, RGBled.cpp, RGBled.h, RGBsensor.cpp, RGBsensor.h, keypad.cpp]
2021-08-08 Enclosure -- MAIN BOX - COMPLETE
    [box-for-proccessor-1.SLDASM, displayReplica.SLDPRT, keypadReplica.SLDPRT, outerBox3 - Copy (5).SLDPRT, outerBox3.SLDPRT, top.SLDPRT]
2021-08-09 AVR codes
    [combined_simmulation.pdsprj, simmulation.pdsprj]
2021-08-09 sensor pcb replica
    [sensor_pcb_replica.SLDPRT]
2021-08-09 Enclosure ( + sensor) complete
    [box-for-proccessor-1.SLDASM, displayReplica.SLDPRT, sensor_assembly.SLDASM, sensor_cover.SLDPRT, sensor_part.SLDPRT, sensor_pcb_replica.SLDPRT]
2021-08-09 beforeadding cuts to box
    [box-for-proccessor-1.SLDASM, sensor_assembly.SLDASM]
2021-08-09 final presentation complete
    [box-for-proccessor-1.SLDASM, sensor_assembly.SLDASM, sensor_part.SLDPRT]
2021-08-11 Finalized work
    [combined_simmulation.pdsprj]
